Razbit/razpu/refs/bmow-arch.pdf

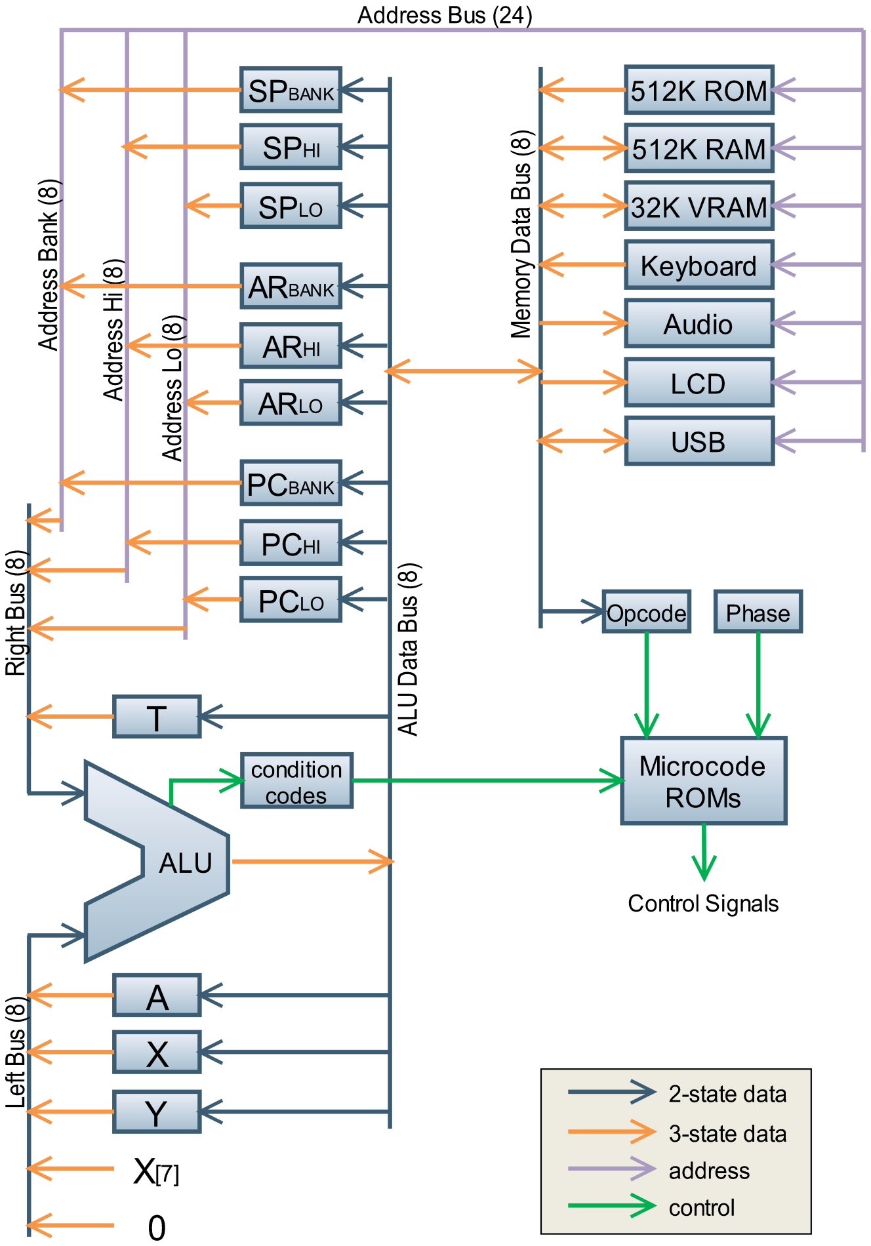
[picture p2: page 1]
