Razbit/razpu/refs/bmow-video.pdf

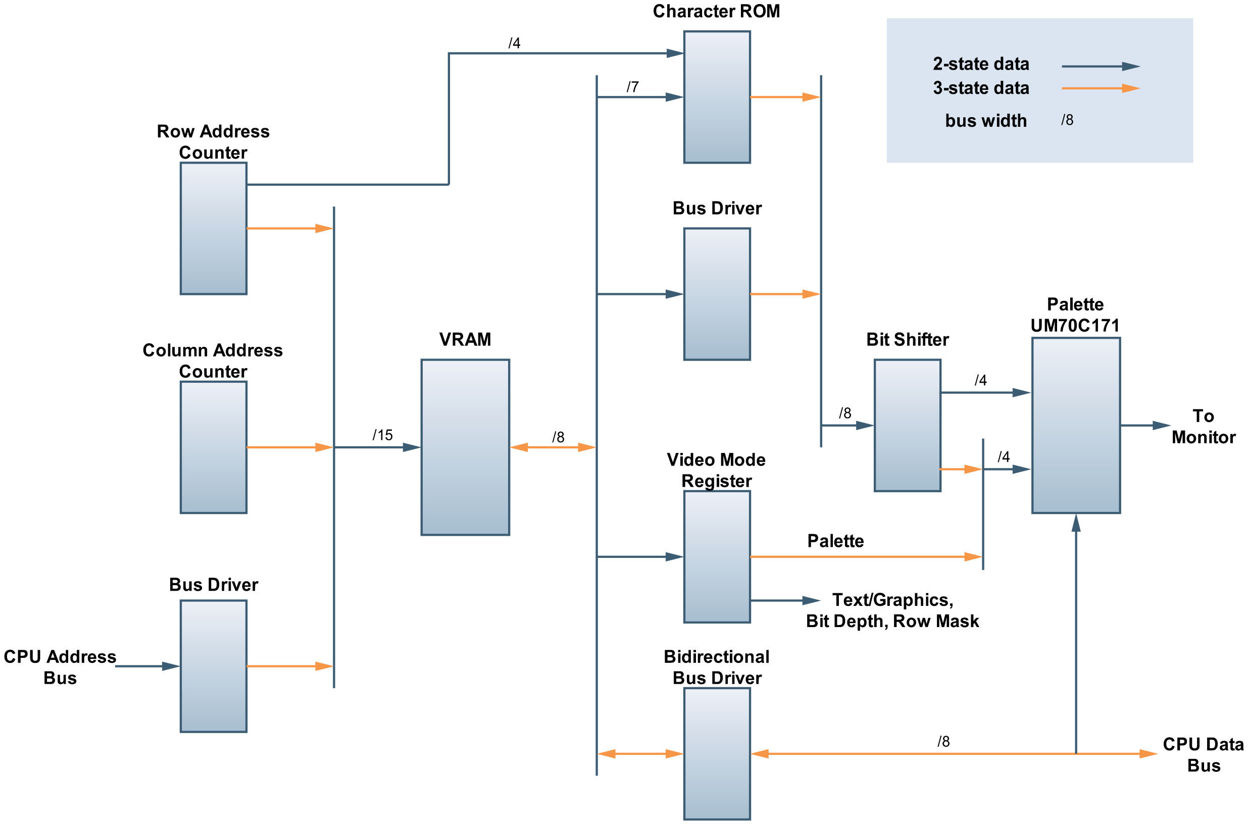
[picture p3: page 1]
