Razbit/razpu/rpu_mk1/schematic.pdf

U1

U2A

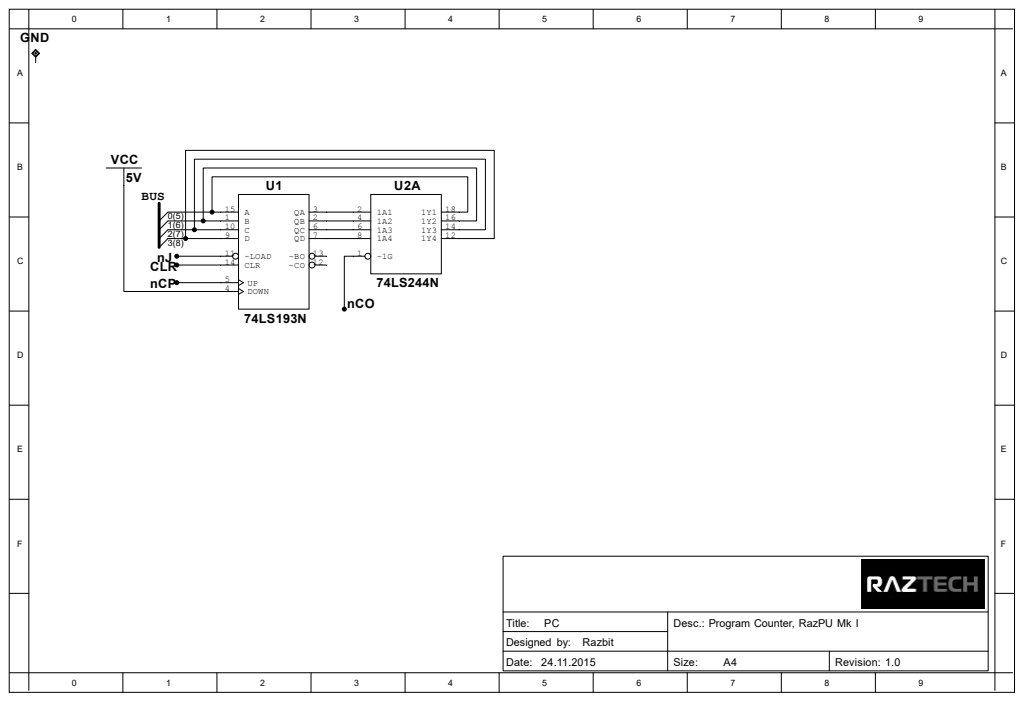
[picture p4: page 1]
DOWN 4; ~LOAD 11; ~CO 12 CLR 14; nCO; nCP; CLRnJ; VCC 5V BUS; Title: Designed by:; Date:; Revision: Size:; Program Counter, RazPU Mk I; Razbit 24.11.2015 1.0 A4; Desc.:; GND

U2

U1

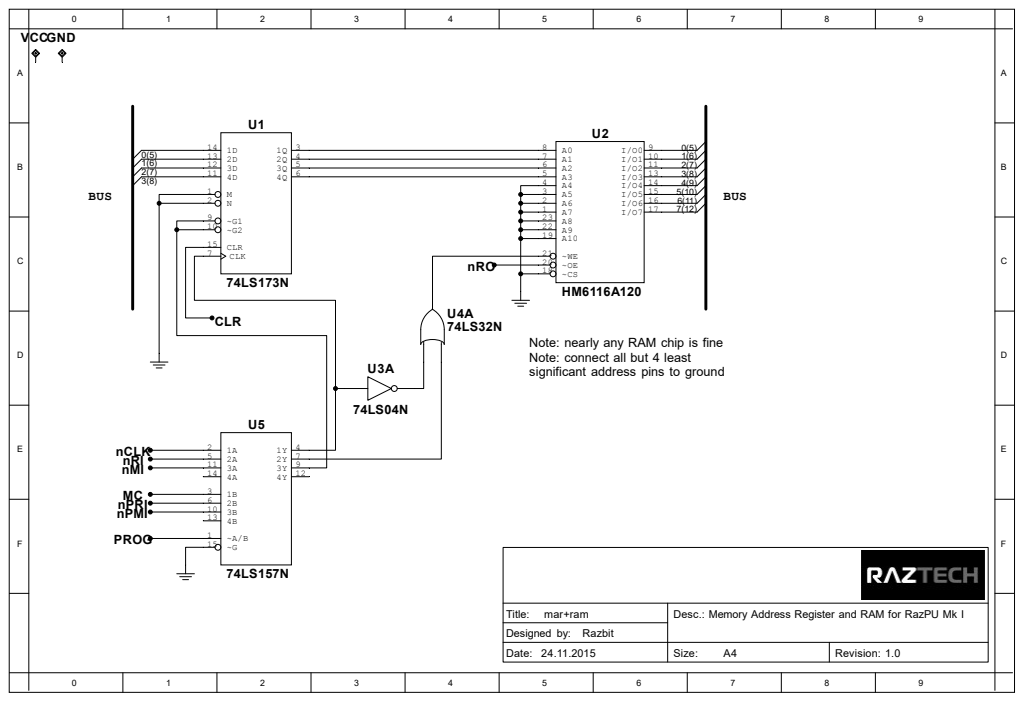
[picture p5: page 2]
nRO; Note: nearly any RAM chip is fine Note: connect all but 4 least significant address pins to ground; BUS; CLR; Title: Designed by:; Date:; Revision: Size:; mar+ram; Memory Address Register and RAM for RazPU Mk I; Razbit 24.11.2015 1.0 A4; Desc.:; ~G1 9 CLR 15; CLK 7; nCLK; PROG; nRI; nPRI; nMI; nPMI; VCCGND

U1

## nIO

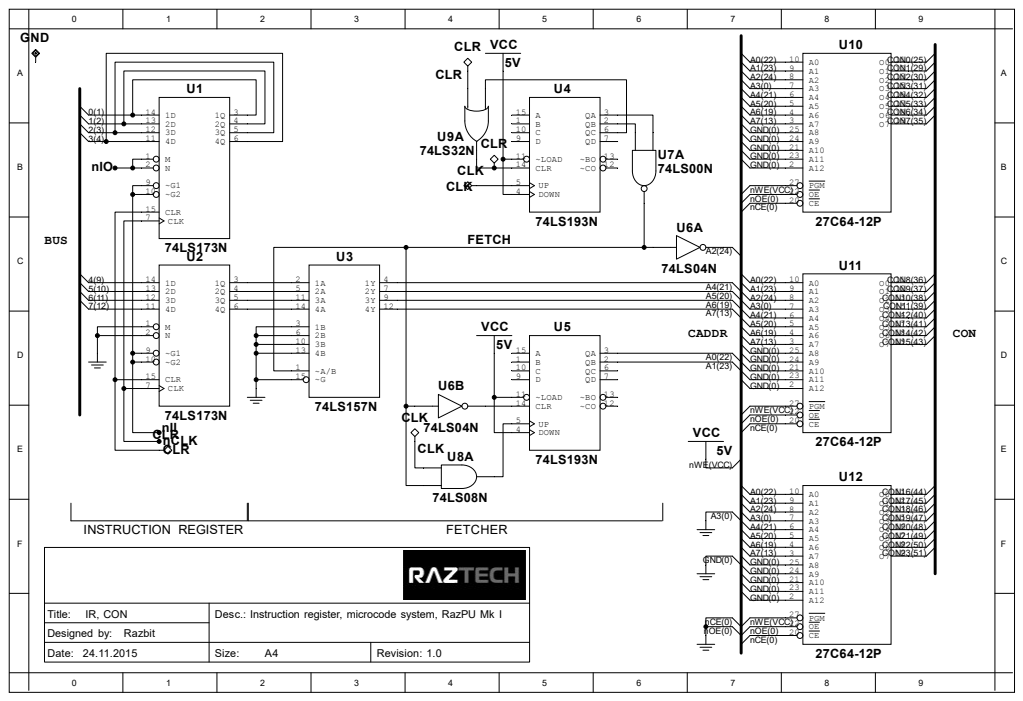
[picture p6: page 3]

GT

EQ

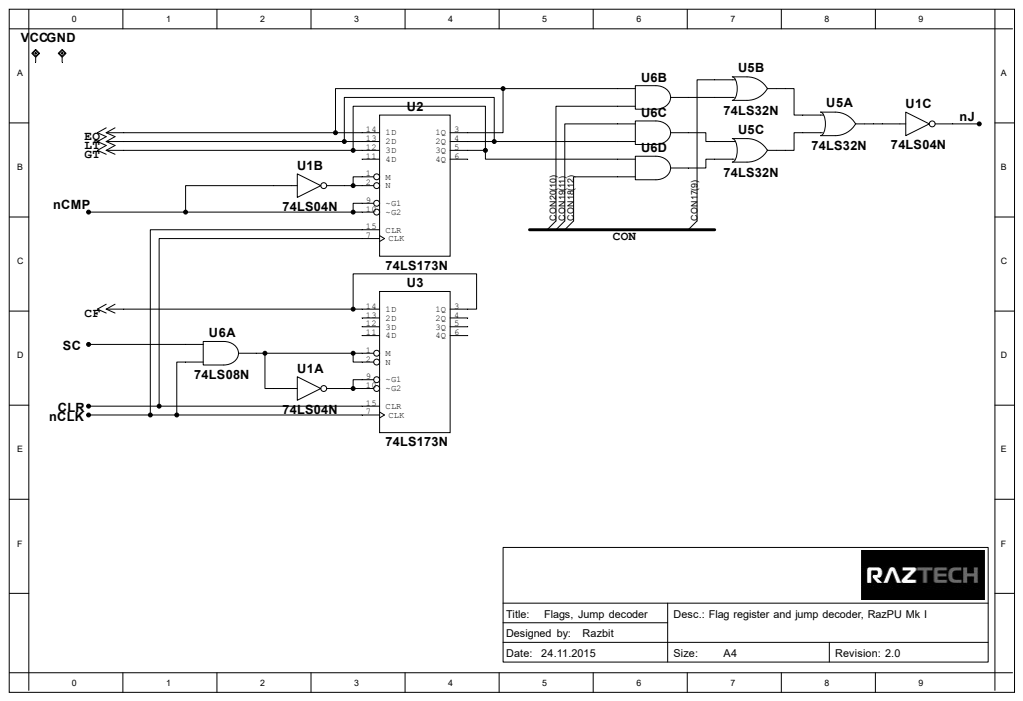
[picture p7: page 4]

U4A

U5

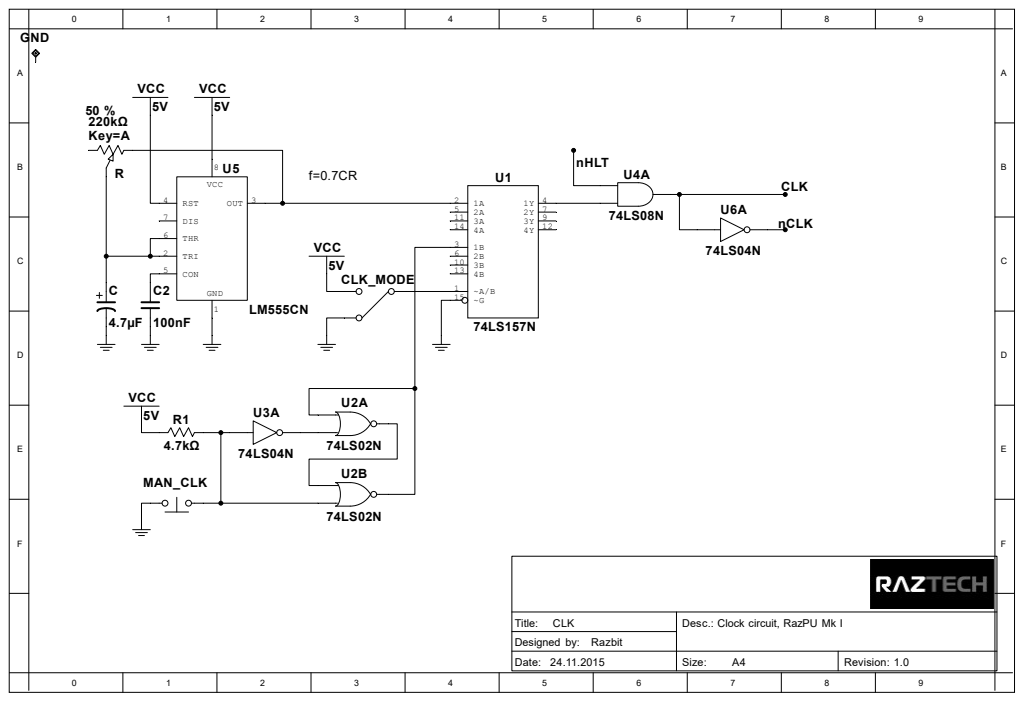
[picture p8: page 5]
GND 1; DIS 7; OUT 3 RST 4; VCC; THR 6; CON 5; TRI 2; MAN_CLK; VCC 5V; CLK_MODE; nHLT; Title: Designed by:; Date:; Revision: Size:; CLK; Clock circuit, RazPU Mk I; Razbit 24.11.2015 1.0 A4; Desc.:; 220kΩ Key=A; CLK nCLK

U1A

U2

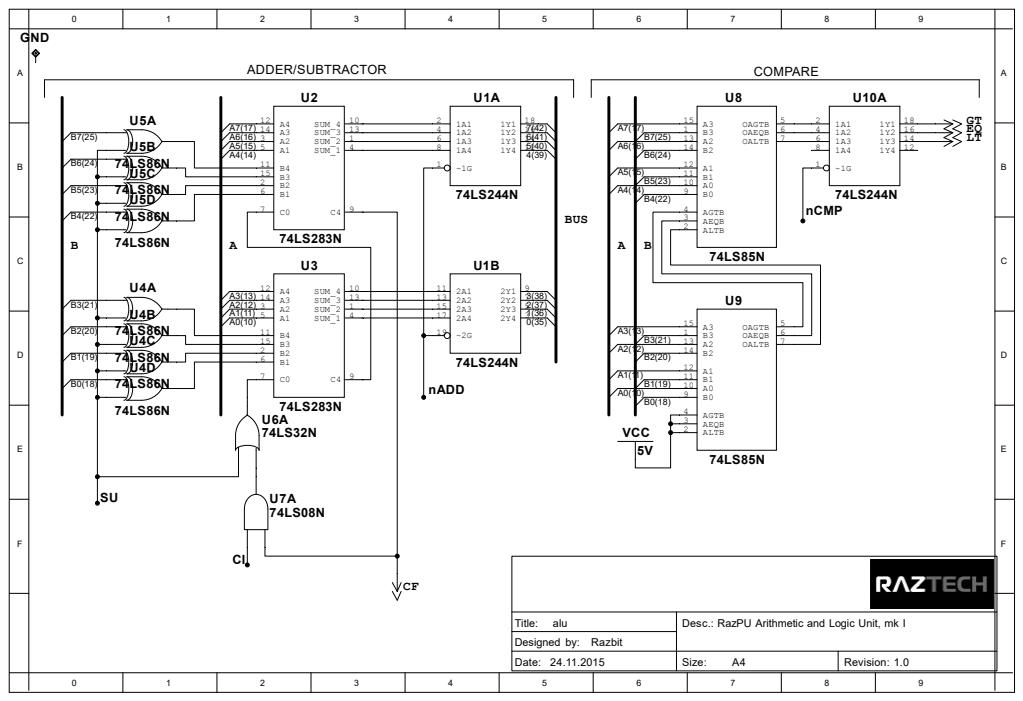
[picture p9: page 6]

U1B

## LPT

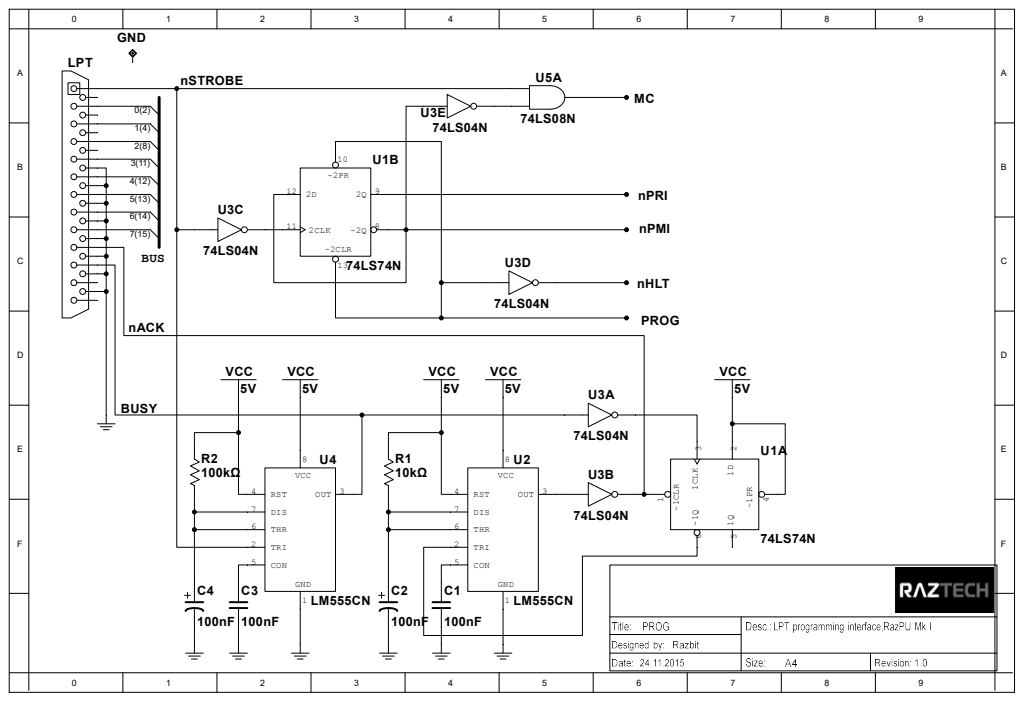
[picture p10: page 7]

U1A

U2

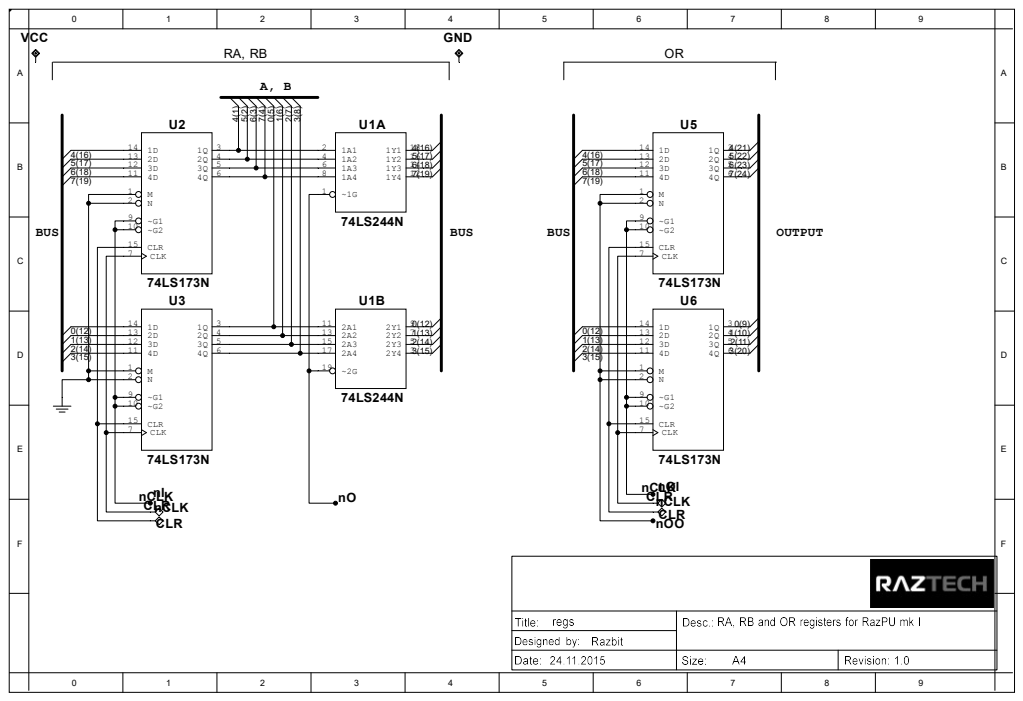
[picture p11: page 8]
~G1 9 CLR 15; CLK 7; BUS; nO nI nCLK; nOI; OUTPUT; nCLK; CLR CLR; nOO; CLR nCLK; VCC; GND
