Razbit/razpu/eeprom_prog.pdf

U4

U5A

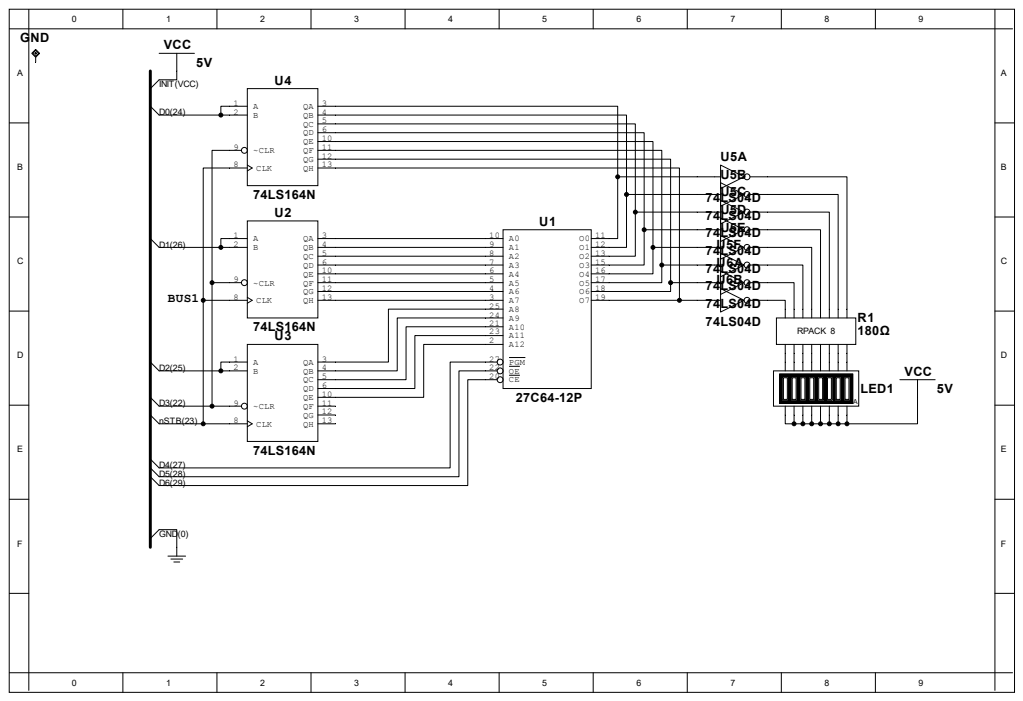
[picture p12: page 1]
