Razbit/razpu/razniffer/pcb_bottom.pdf

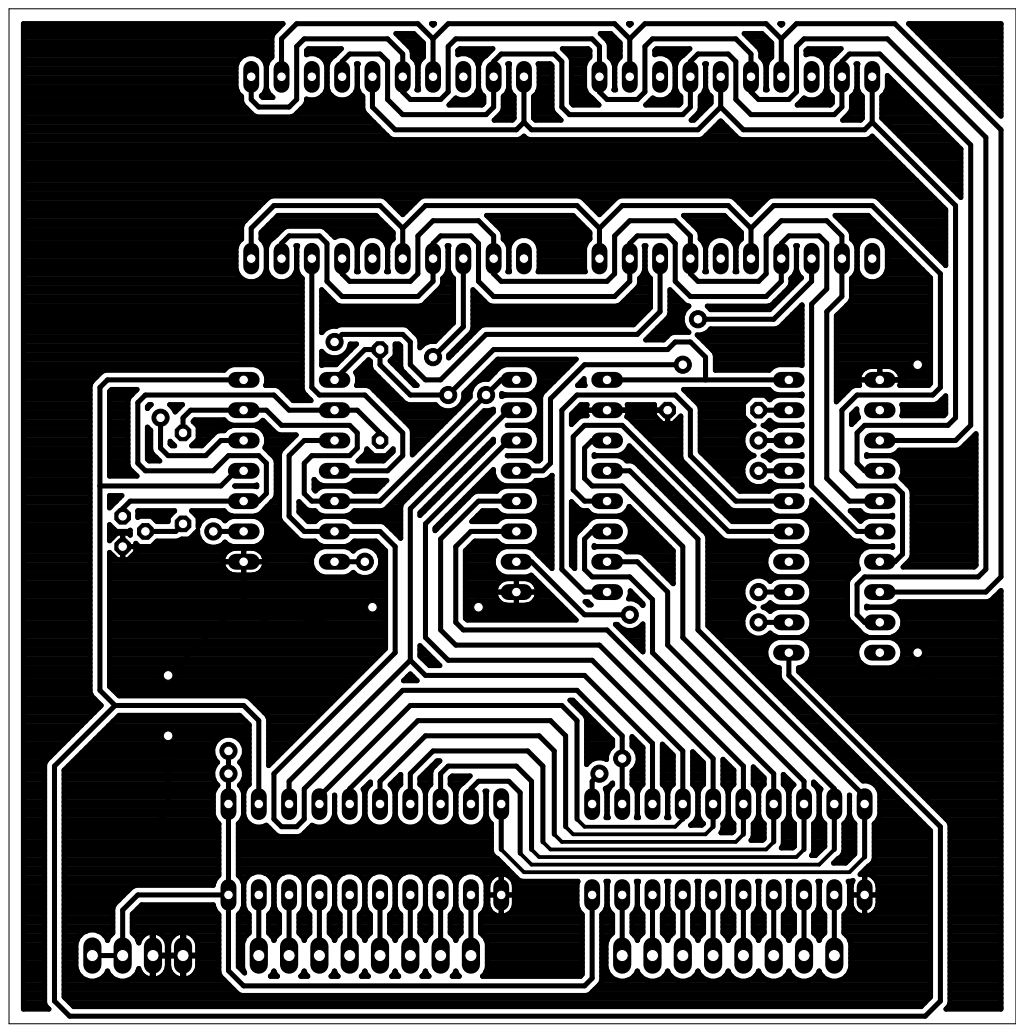
[picture p13: page 1]
