Razbit/razpu/razniffer/pcb_top.pdf

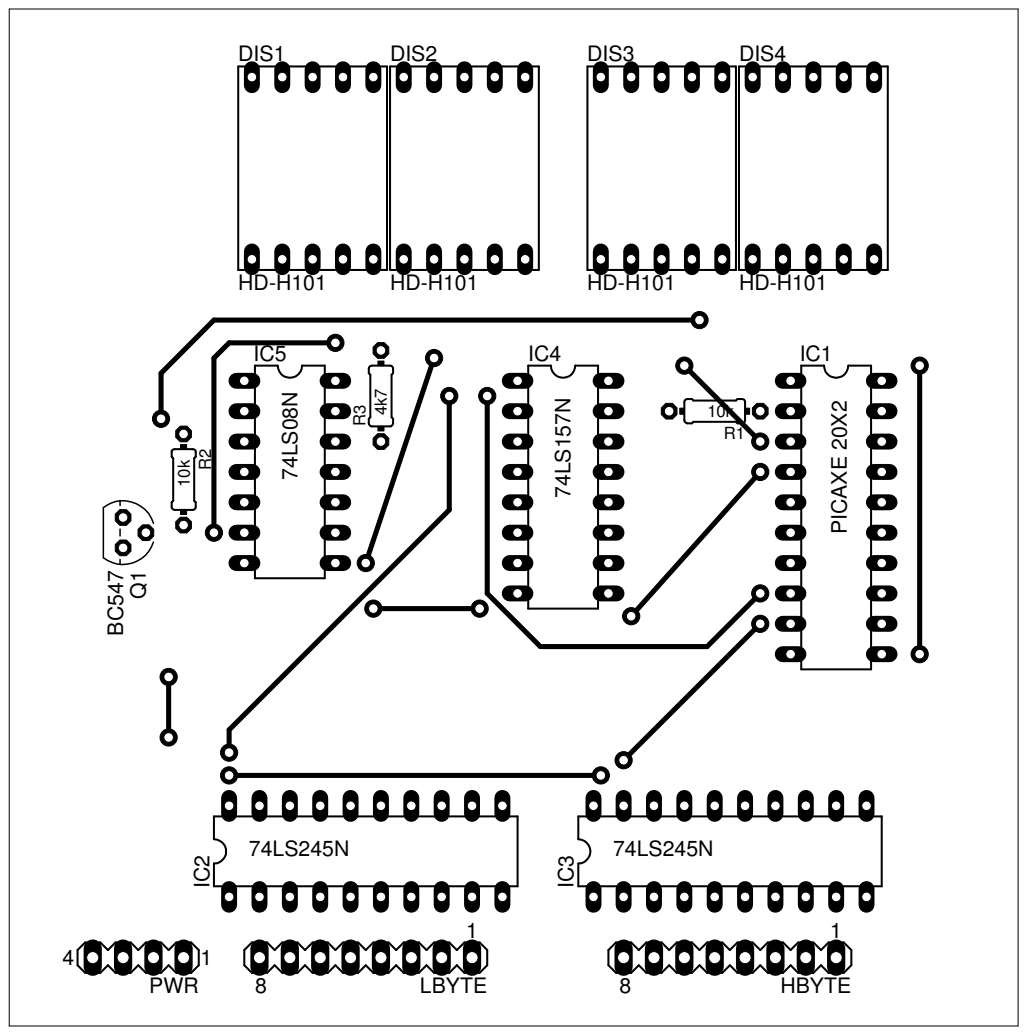
[picture p14: page 1]
