Razbit/razpu/refs/bmow-schema.pdf

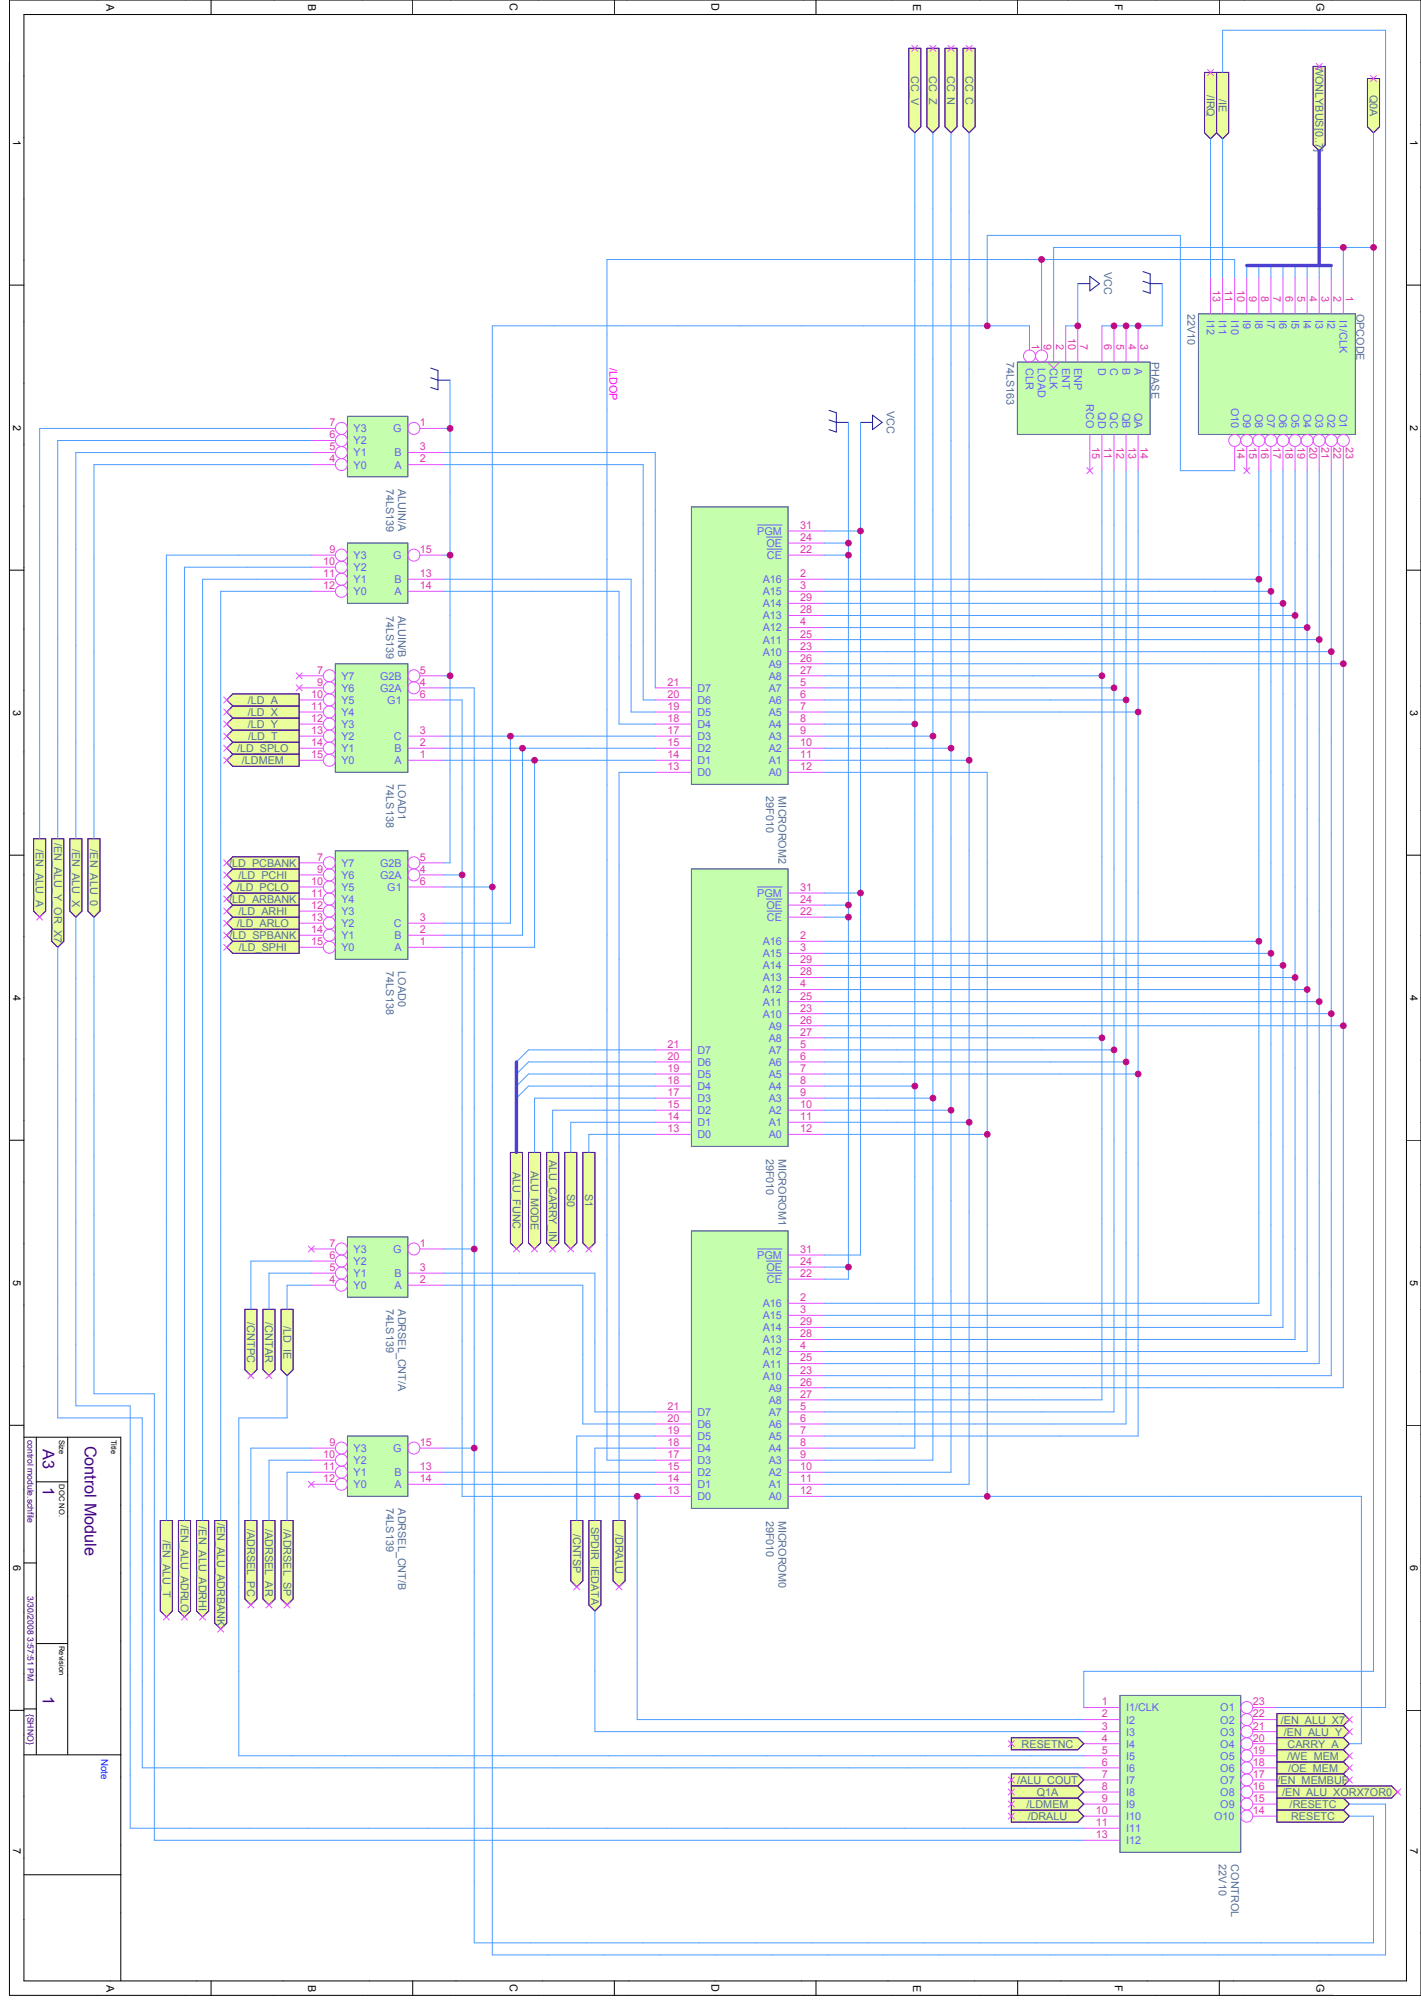
[picture p15: page 1]

3 A 14 QA 4 B 13 QB 5 C 12 QC 6 D 11 QD 15 RCO 7 ENP 10

23 A10
26 A9
27 A8

28 A13
25 A11 4

control module.schfile 3/30/2008 3:57:51 PM {SHNO}

Size DOC NO. Revision

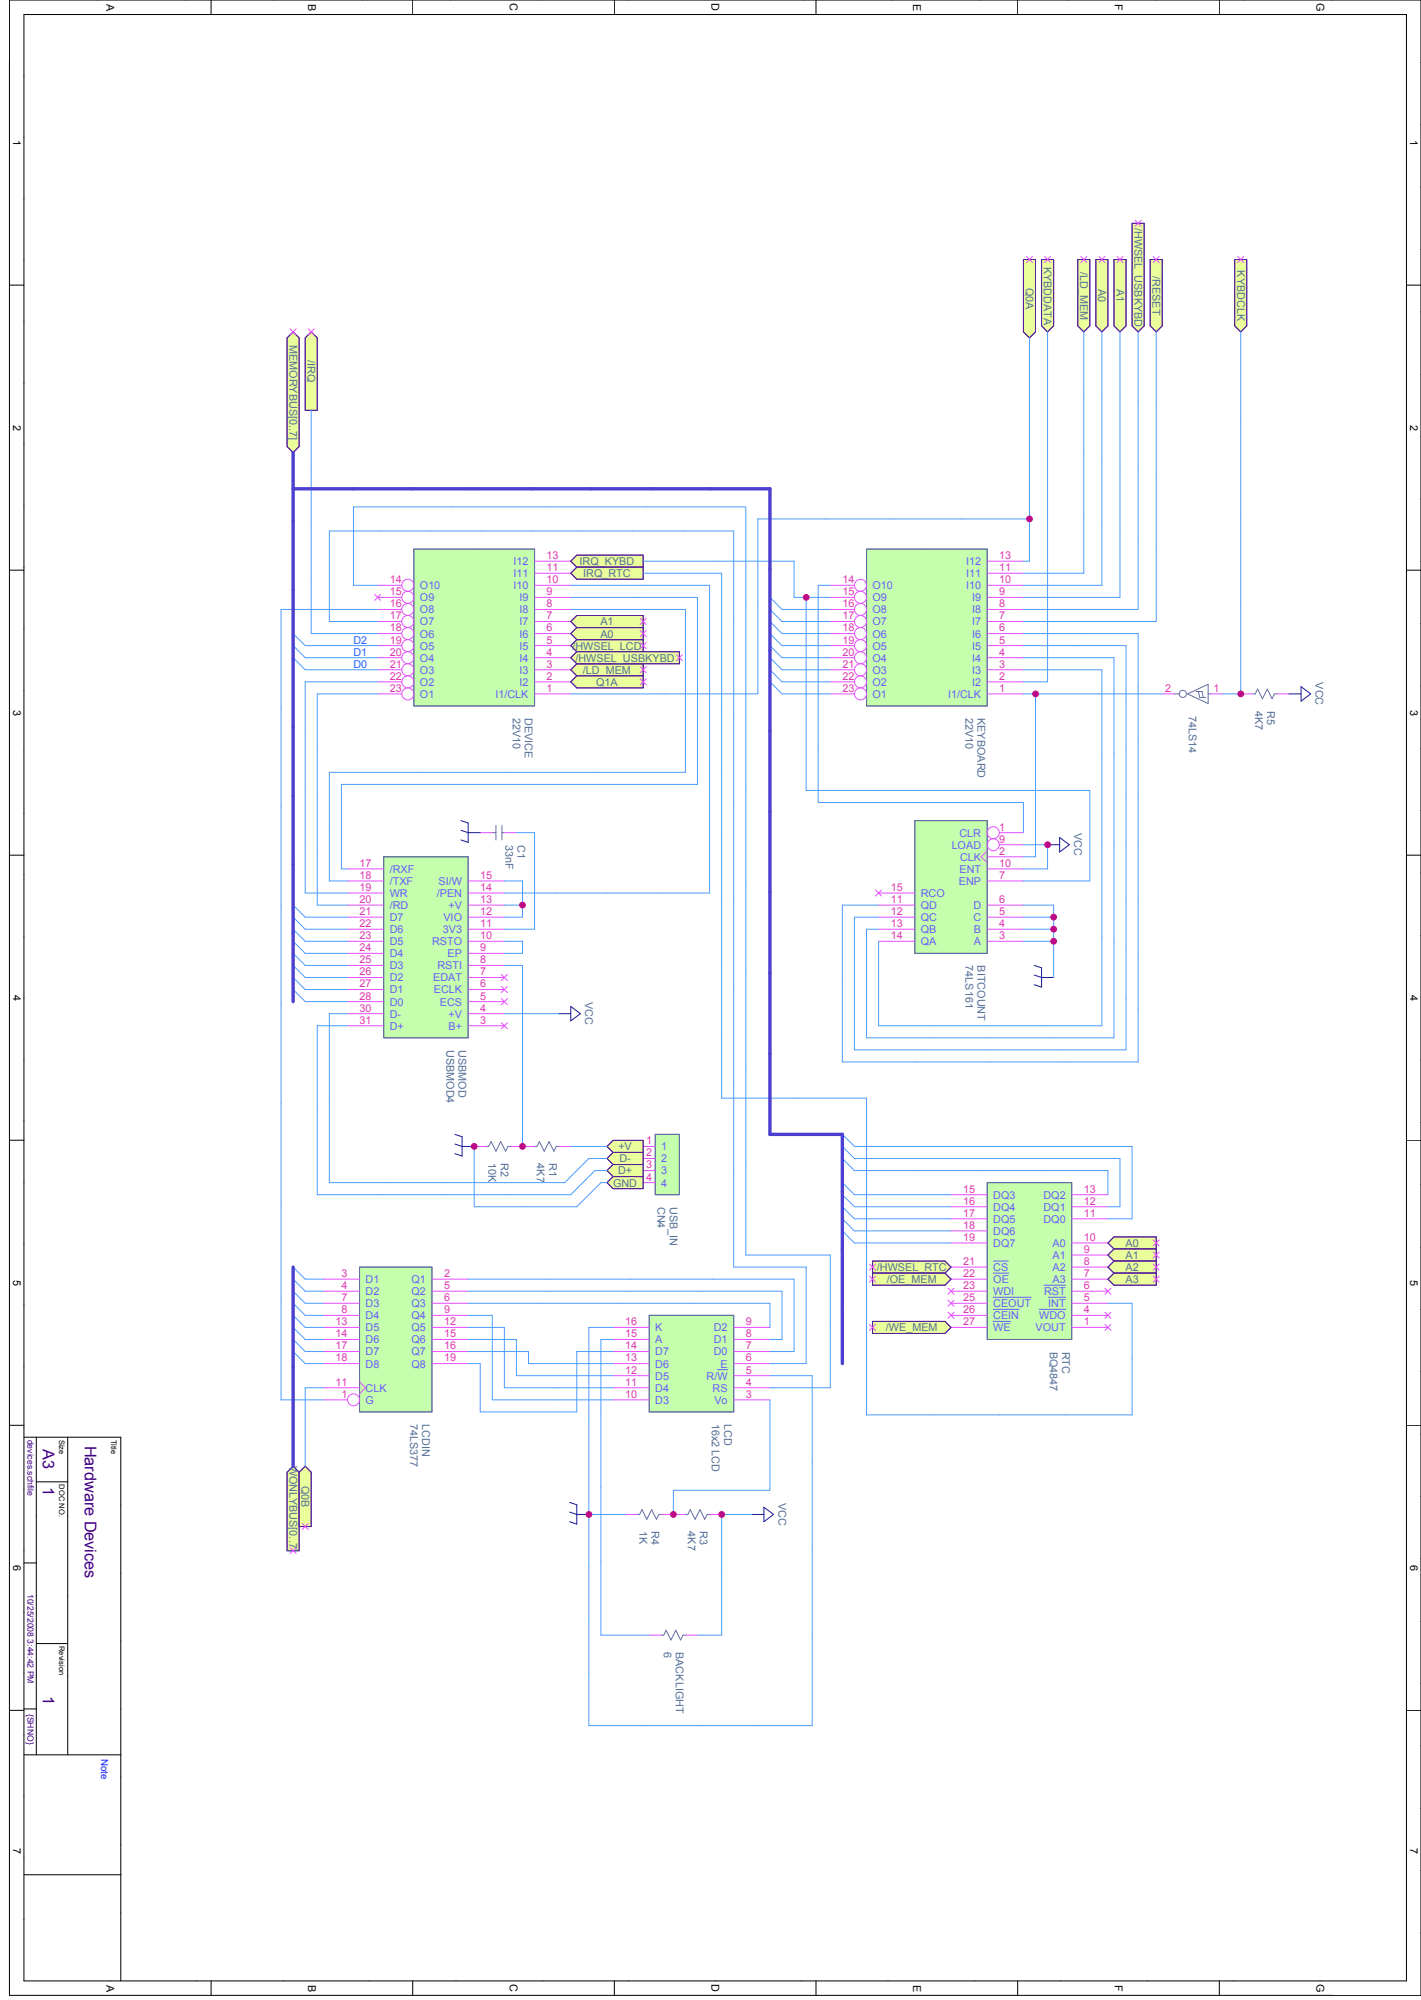
[picture p16: page 2]

devices.schfile 10/25/2008 3:44:42 PM {SHNO}

Size DOC NO. Revision

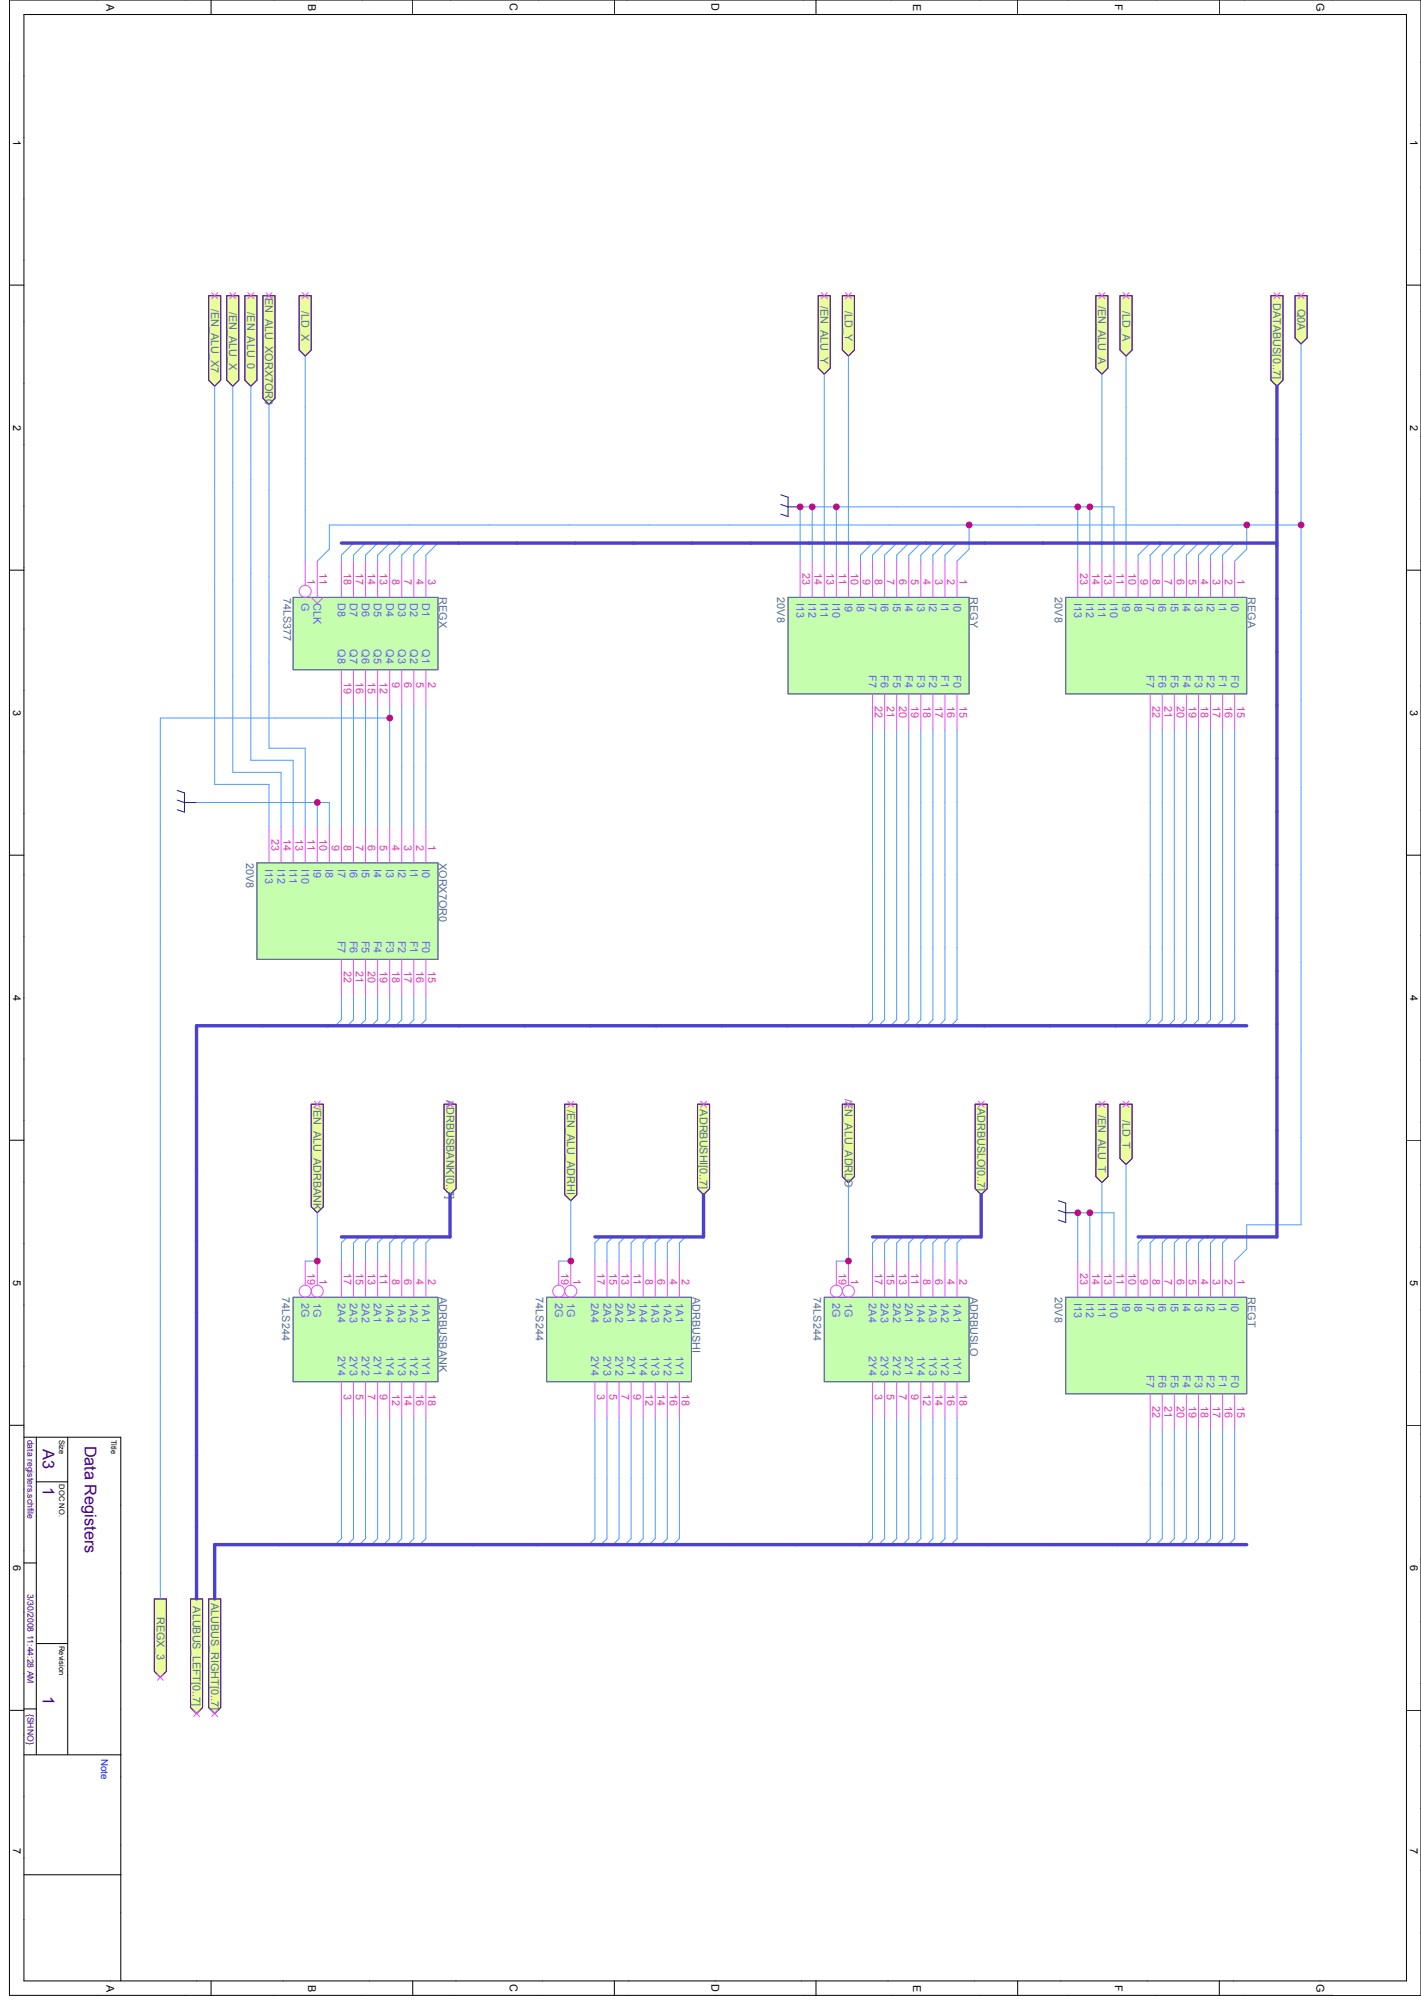
[picture p17: page 3]

data registers.schfile 3/30/2008 11:44:28 AM {SHNO}

Size DOC NO. Revision

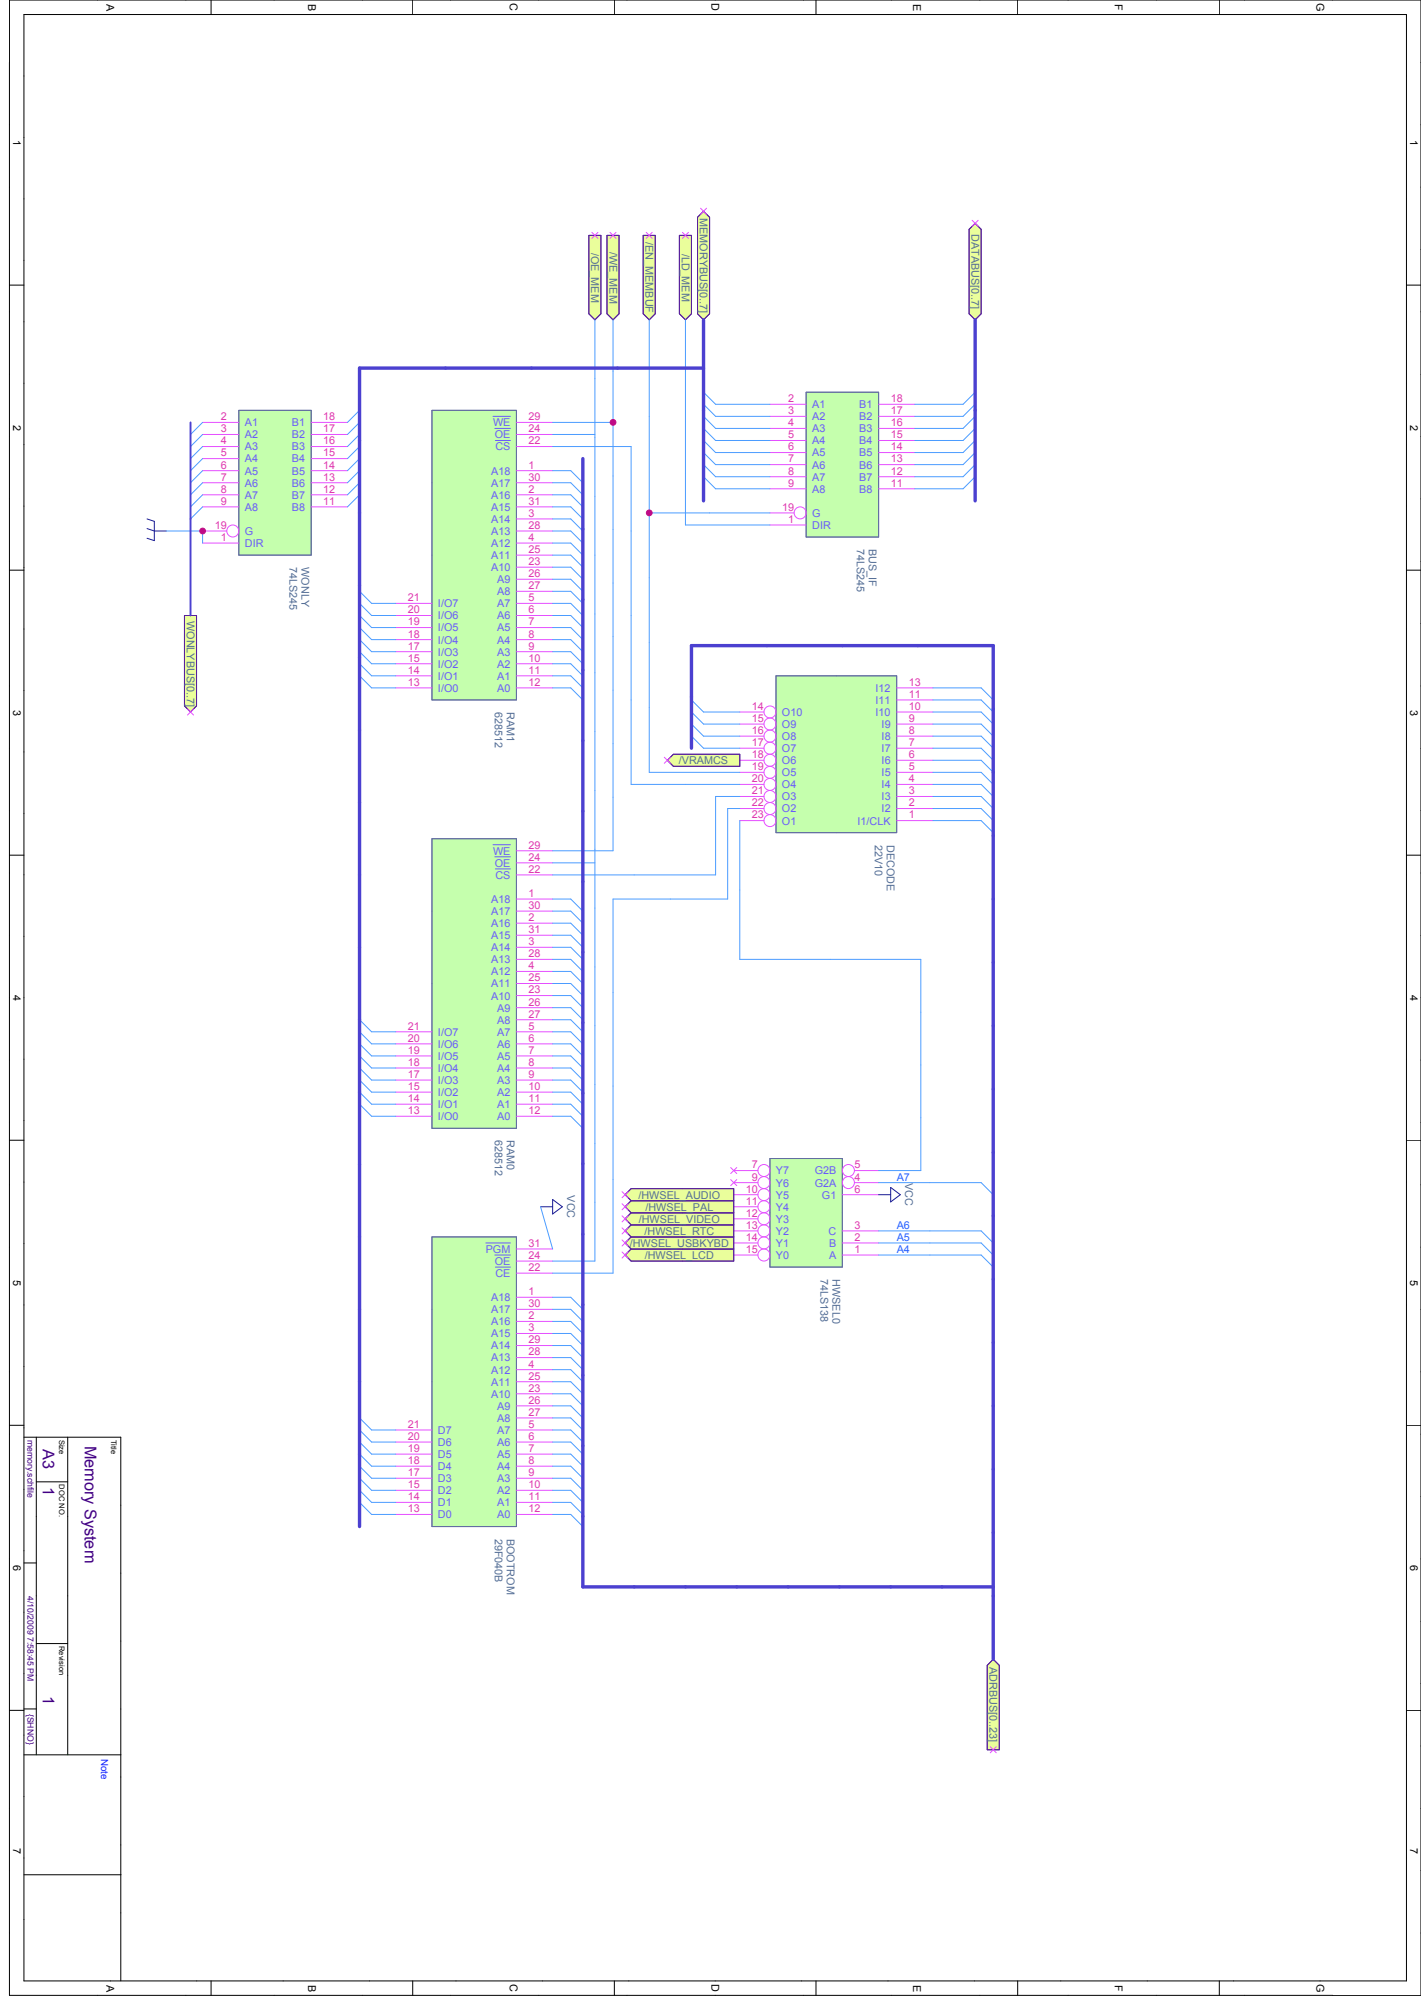
[picture p18: page 4]

memory.schfile 4/10/2009 7:58:45 PM {SHNO}

Size DOC NO. Revision

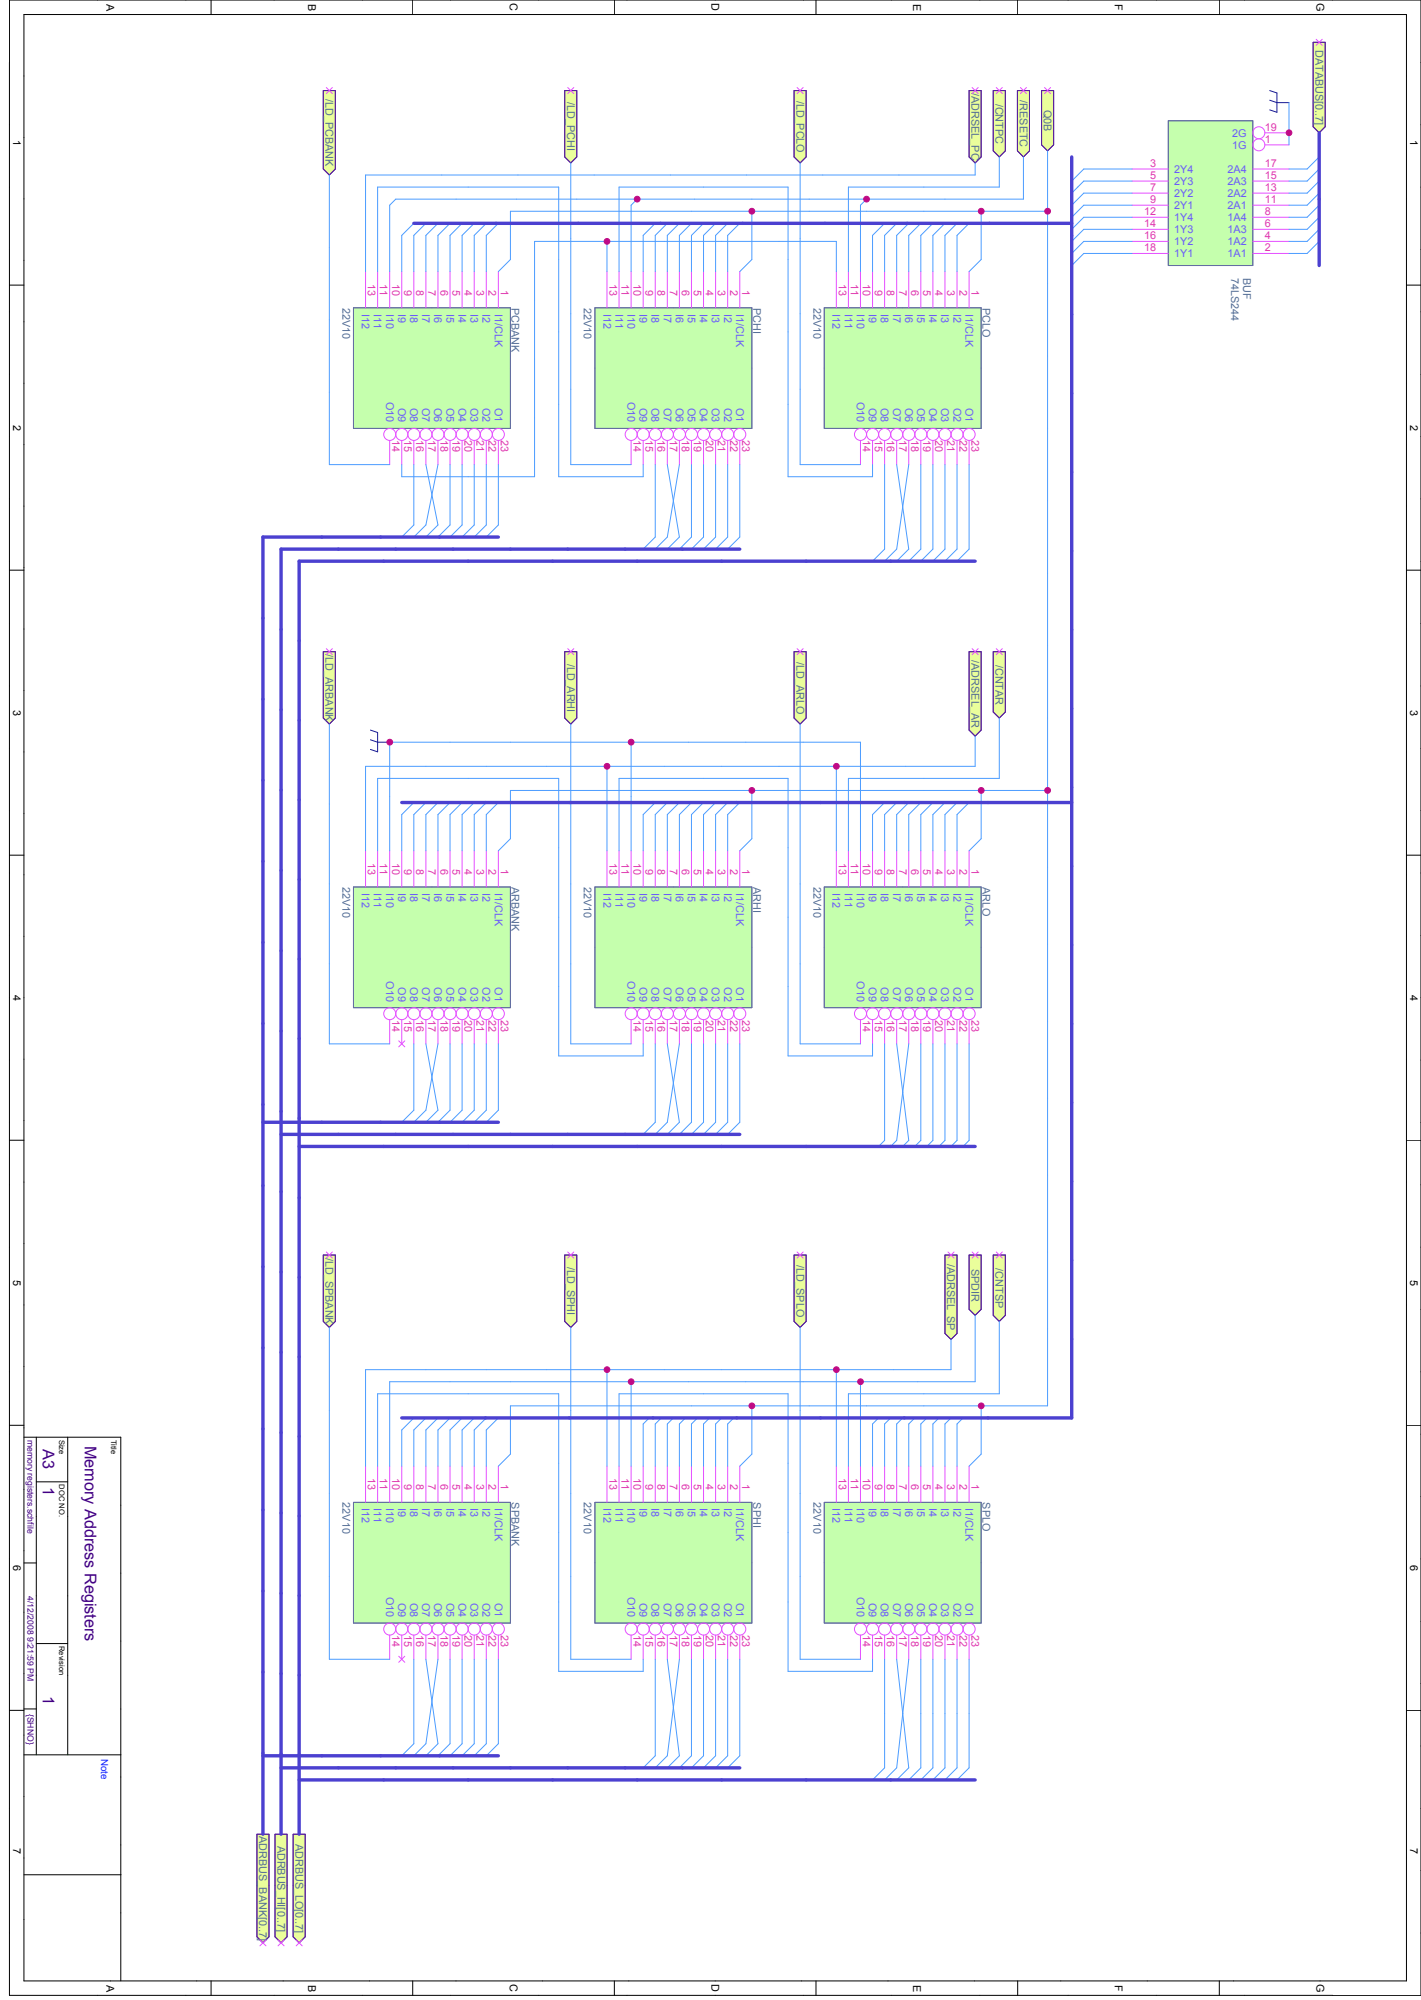
[picture p19: page 5]
Note; Title; PCLO; 1 I1/CLK; PCHI; PCBANK; ARLO; ARHI; ARBANK; SPLO; SPHI; SPBANK; BUF; /CNTPC; /ADRSEL_PC; /LD_PCBANK; /LD_PCHI; /LD_PCLO; /LD_ARHI; /LD_ARLO; /ADRSEL_AR; /LD_ARBANK; /LD_SPHI; /LD_SPLO; /LD_SPBANK; /CNTAR; SPDIR; /CNTSP; /ADRSEL_SP; DATABUS[0..7]; ADRBUS_BANK[0..7]; ADRBUS_HI[0..7]; ADRBUS_LO[0..7]; /RESETC

memory registers.schfile 4/12/2008 9:21:59 PM {SHNO}

Size DOC NO. Revision

Memory Address Registers

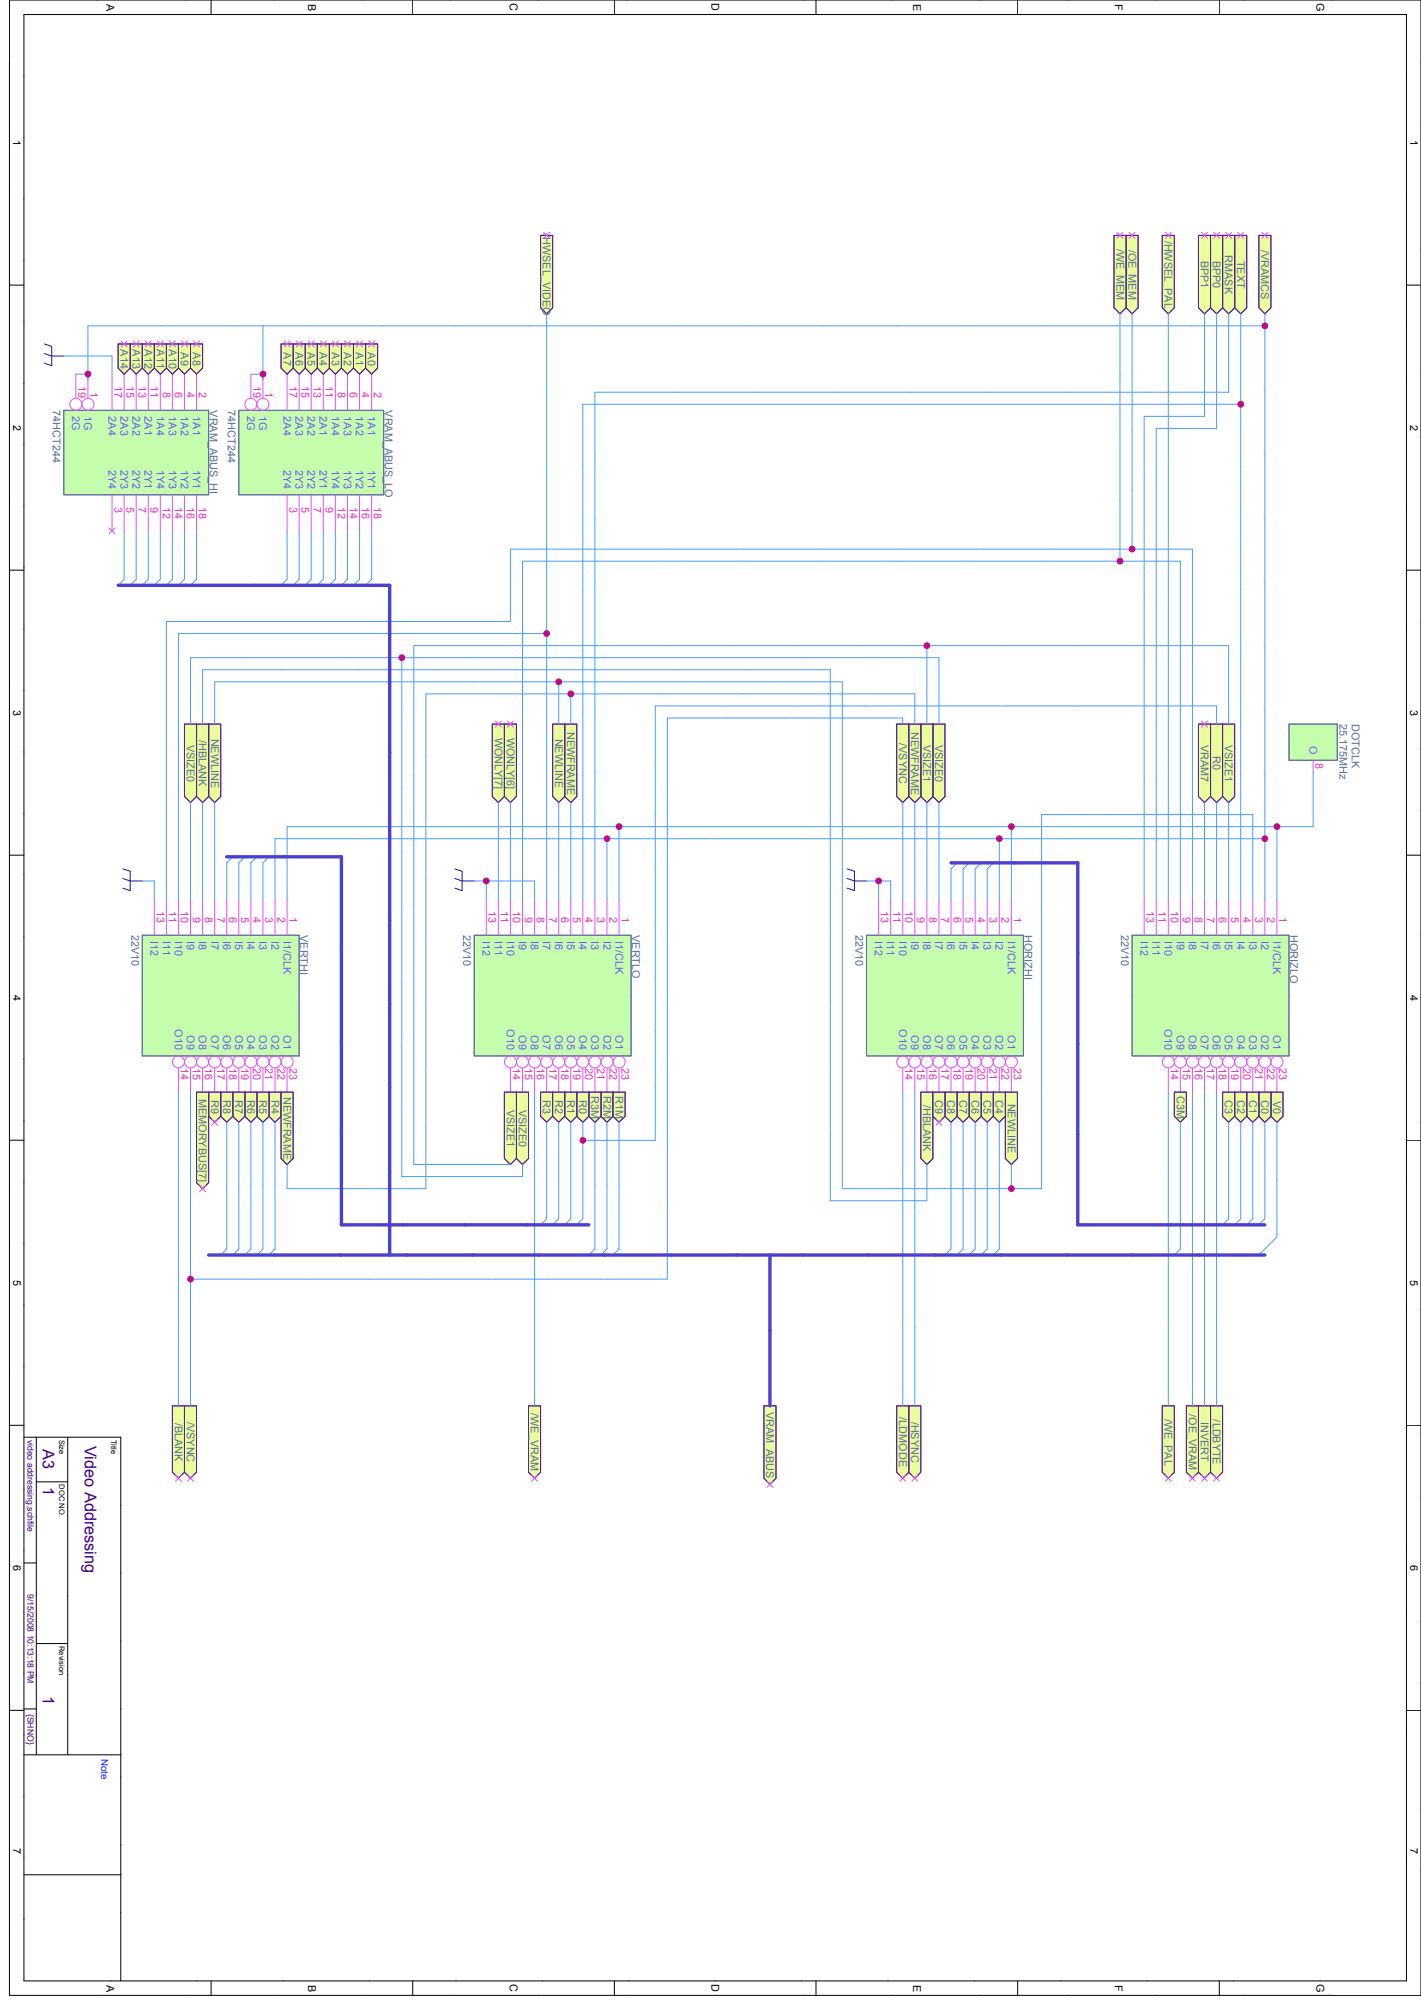
[picture p20: page 6]

video addressing.schfile 9/15/2008 10:13:18 PM {SHNO}

Size DOC NO. Revision

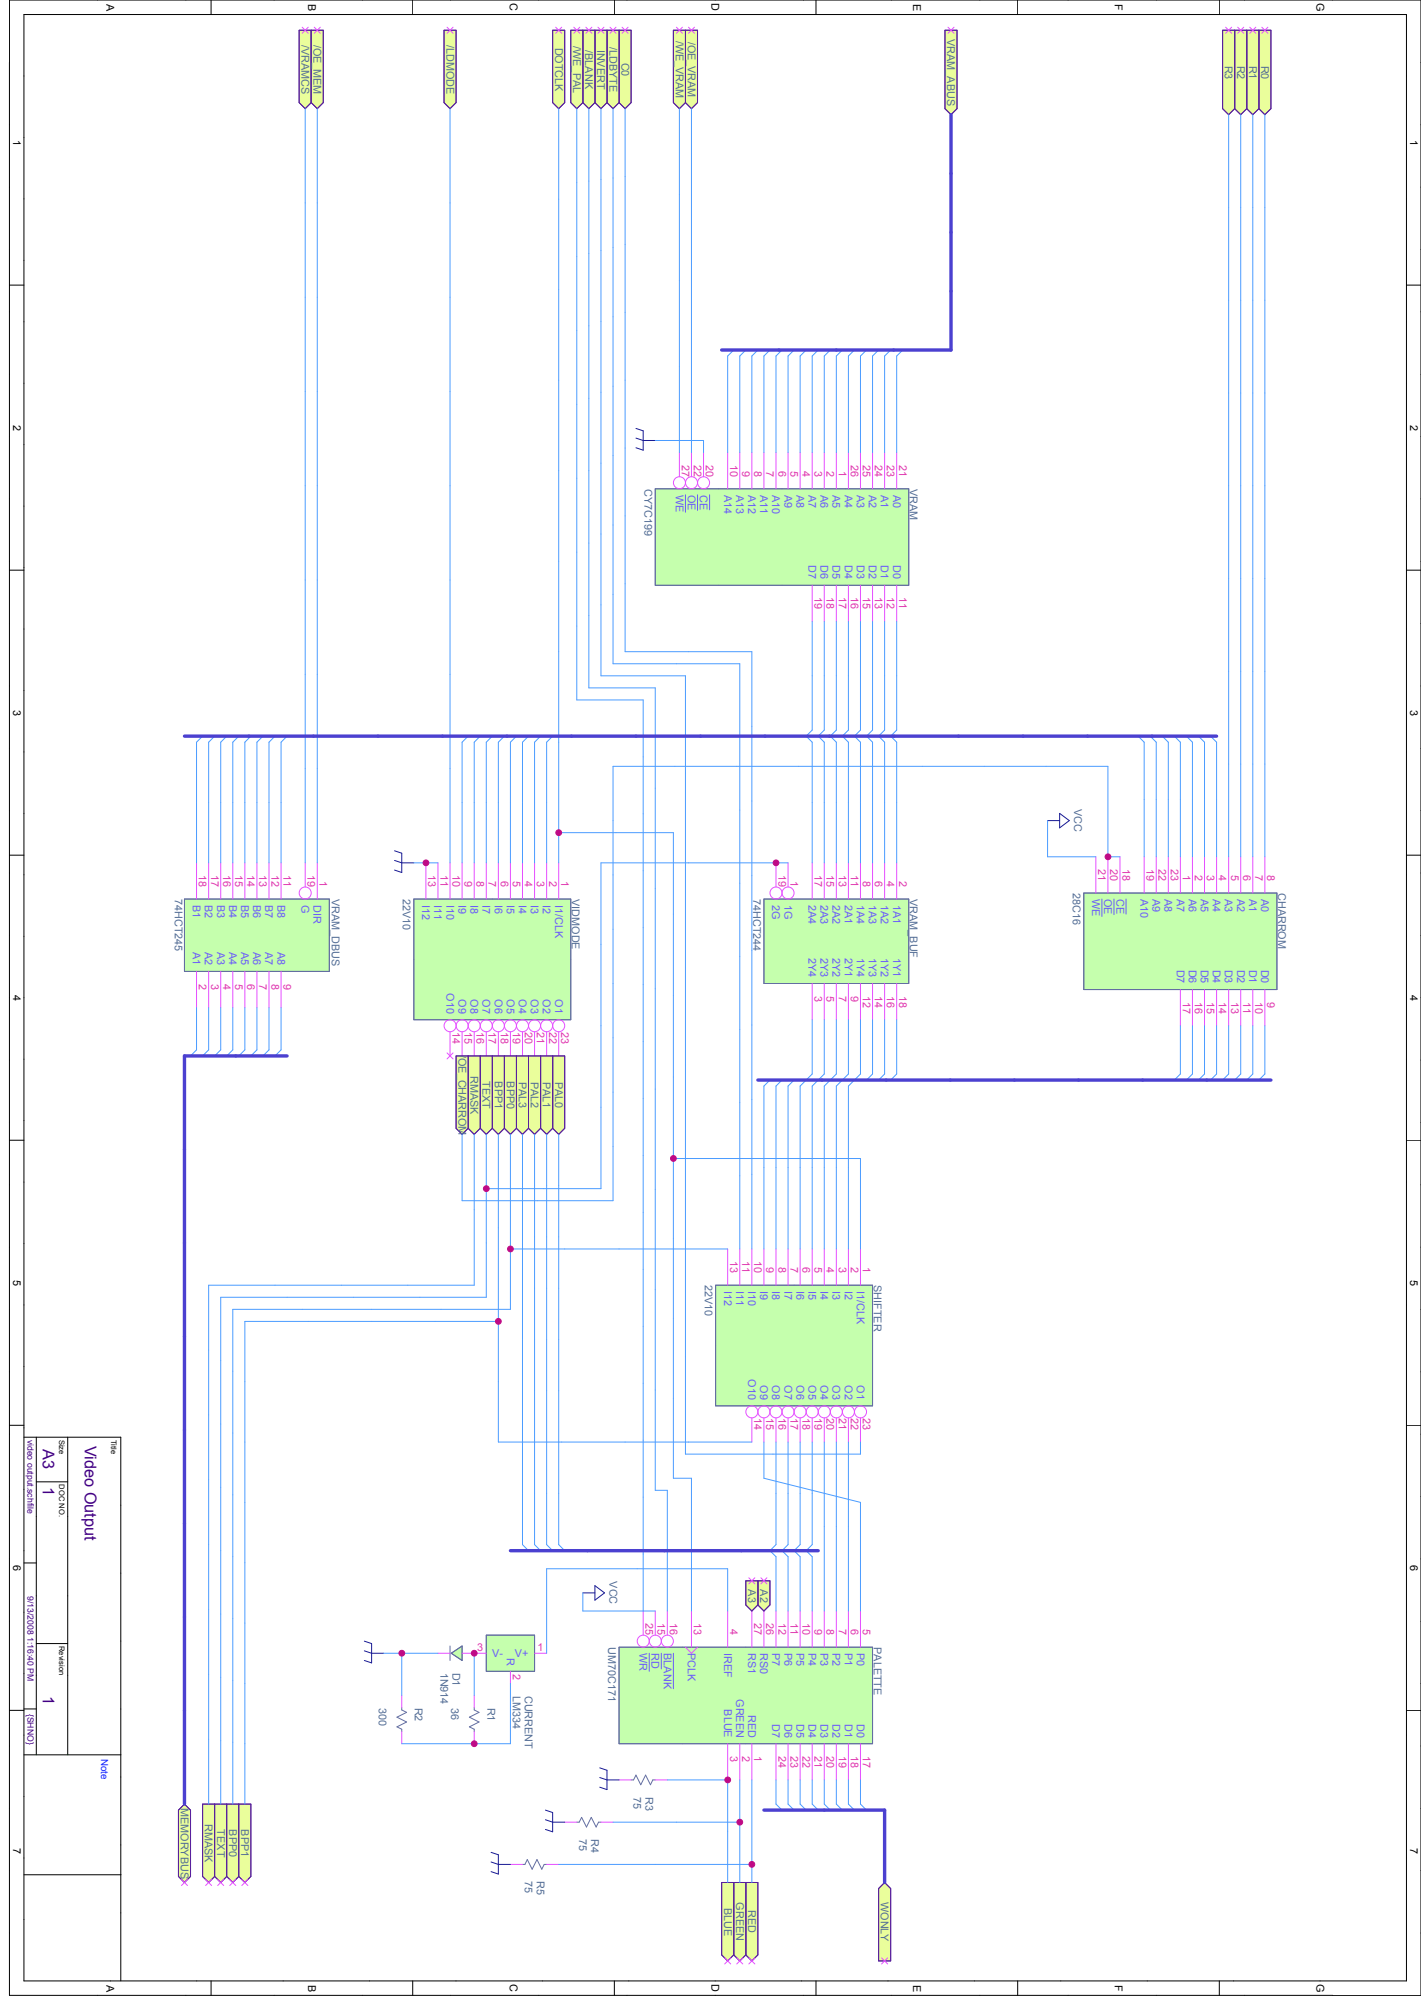
[picture p21: page 7]

video output.schfile 9/13/2008 1:16:40 PM {SHNO}

Size DOC NO. Revision

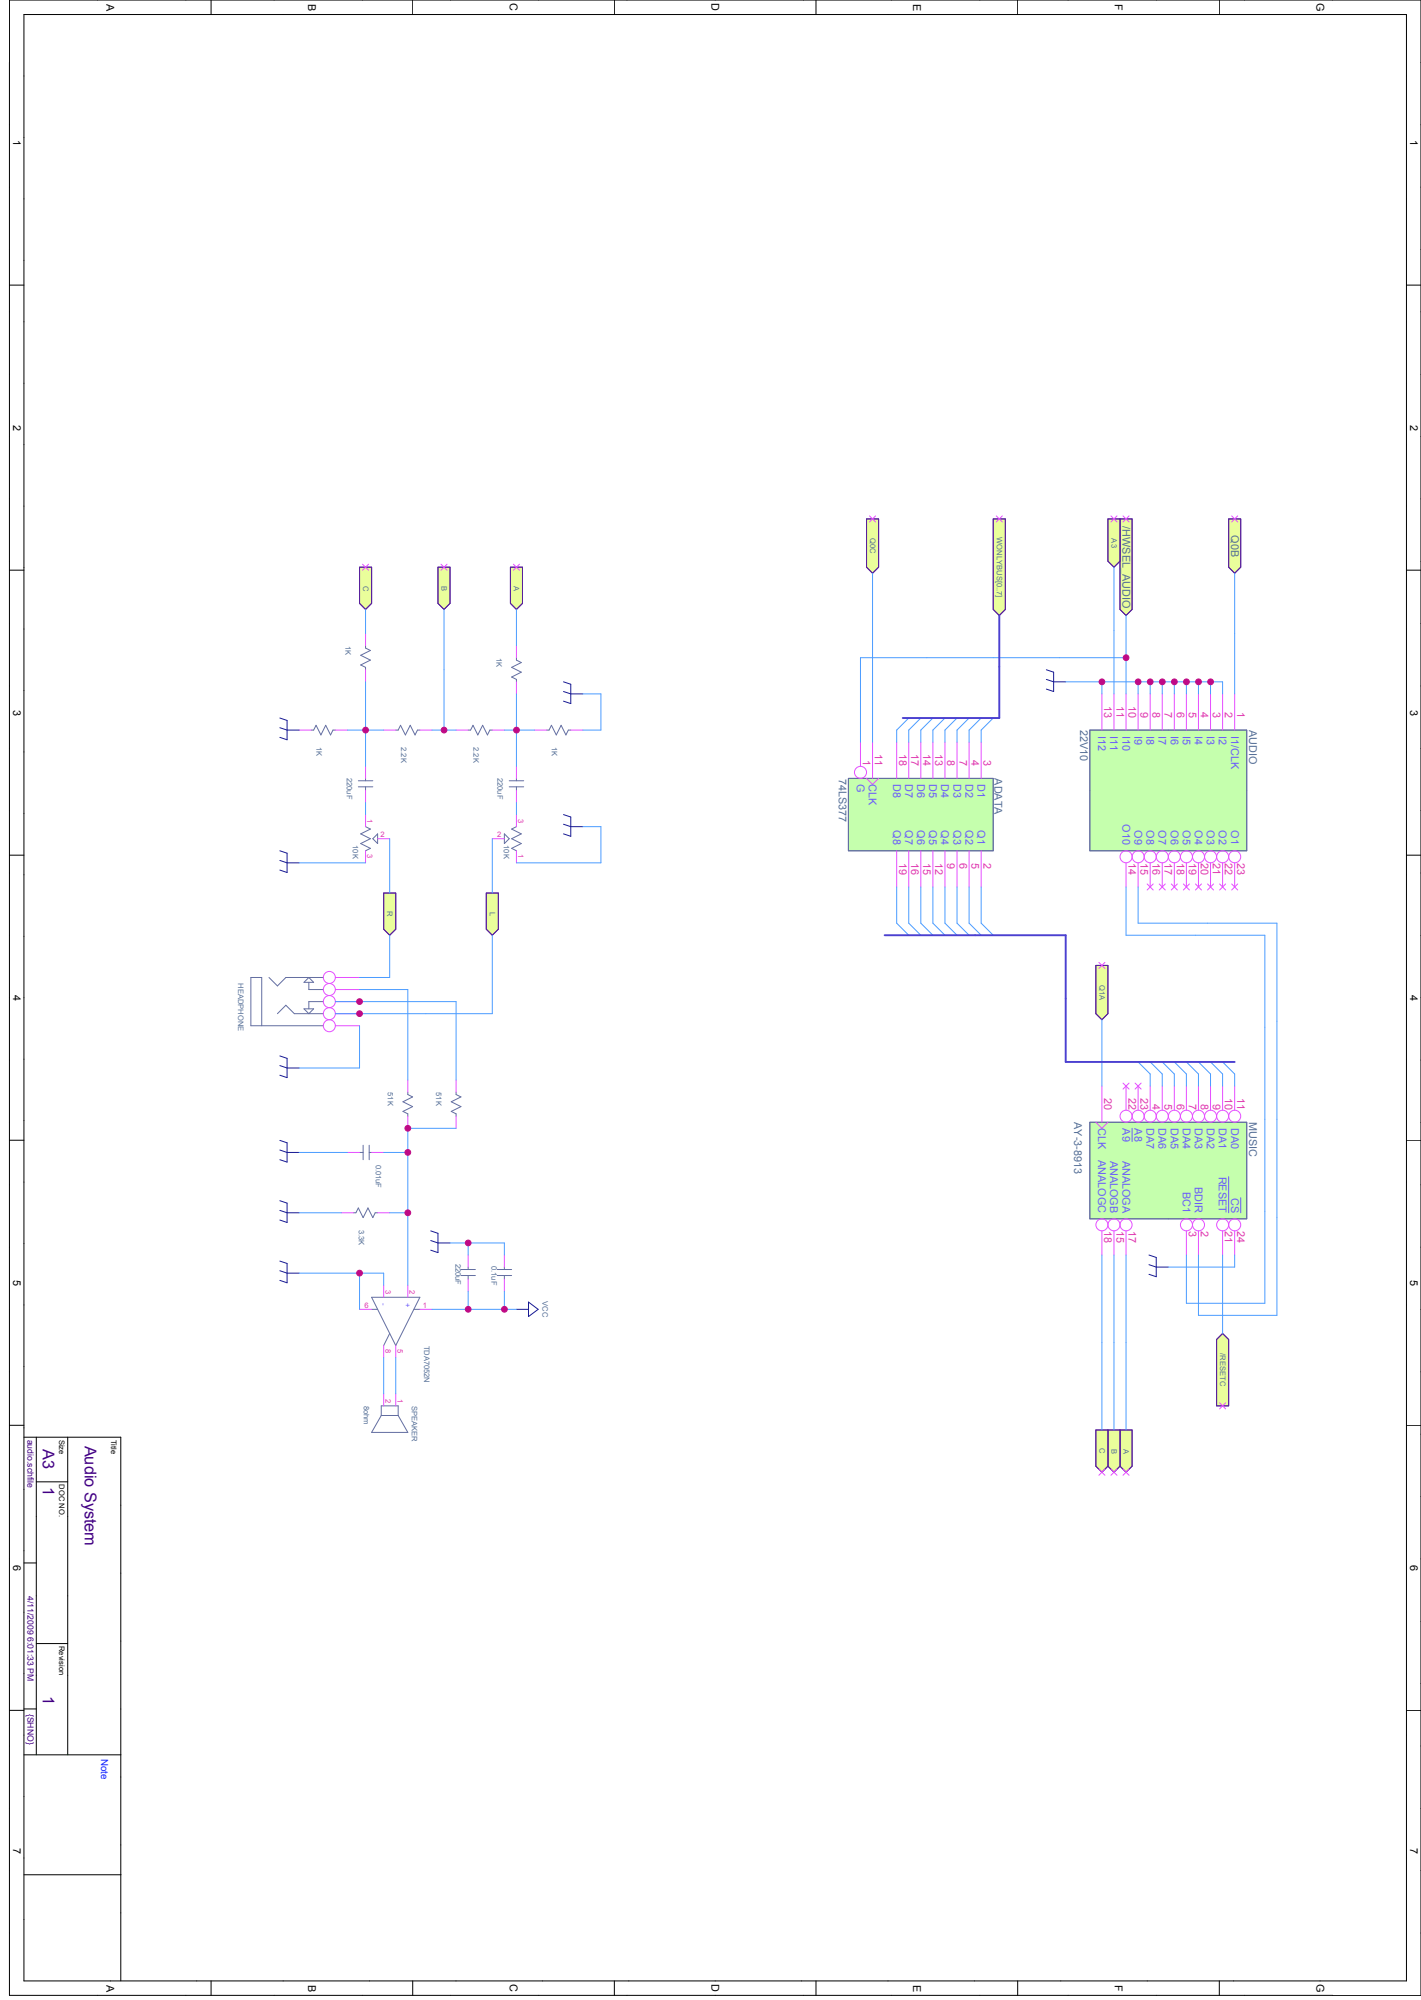
[picture p22: page 8]

audio.schfile 4/11/2009 6:01:33 PM {SHNO}

Size DOC NO. Revision

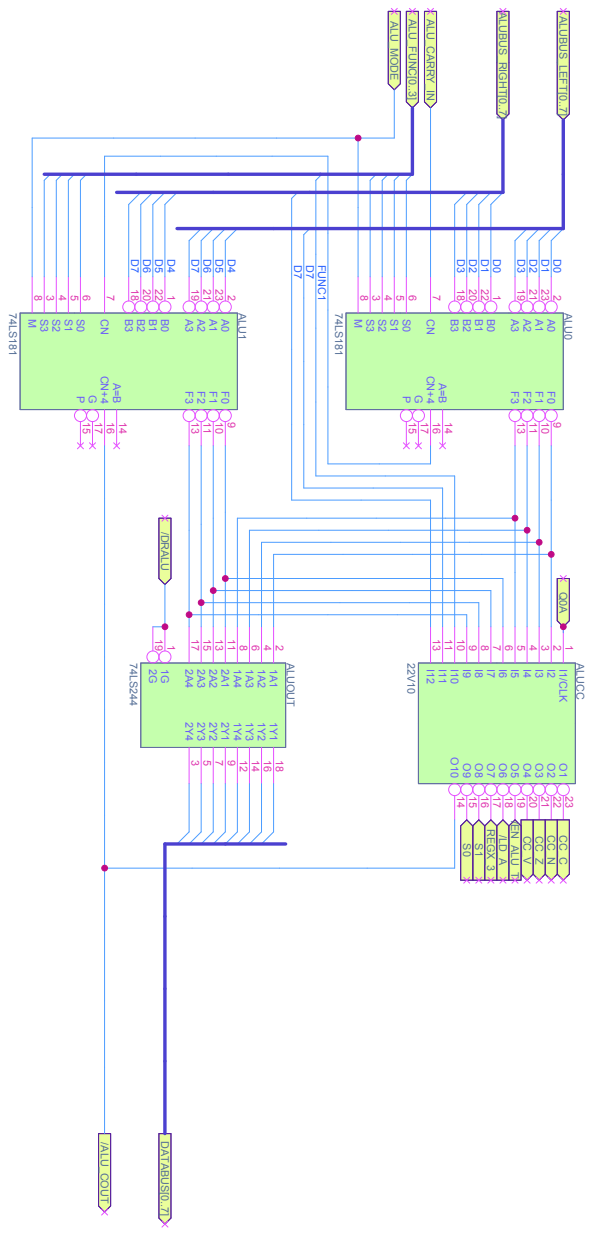
[picture p23: page 9]

ALU.schfile 11/10/2008 10:14:26 PM {SHNO}

Size DOC NO. Revision

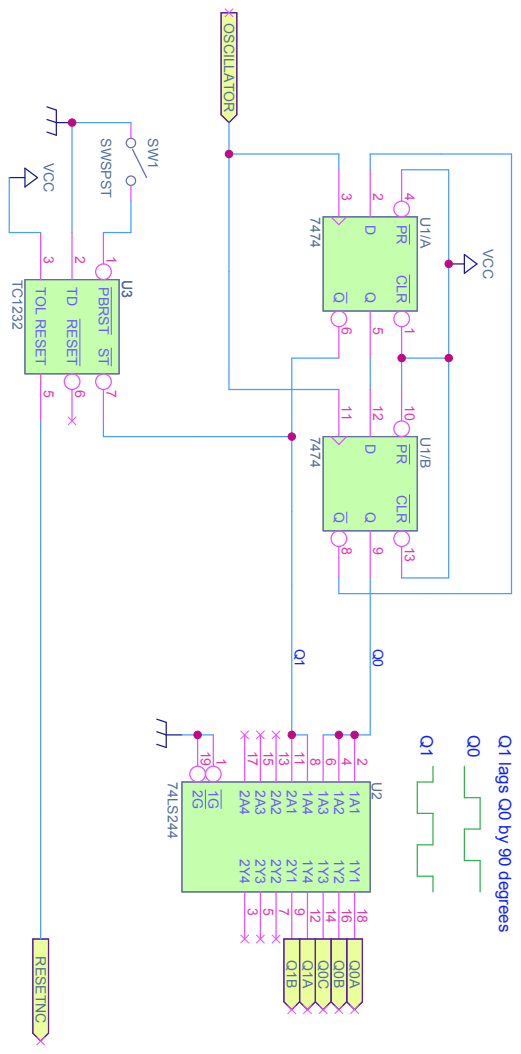
[picture p24: page 10]

clock generator.schfile 3/8/2008 4:05:28 PM {SHNO}

Size DOC NO. Revision
