Razbit/razpu/rpu_mk1/alu.pdf

U1A

U2
