Razbit/razpu/rpu_mk1/flags.pdf

GT

EQ
