Razbit/razpu/rpu_mk1/instr_reg+ctrl.pdf

U1

## nIO
