Razbit/razpu/(list of files, drawings)

Other design files:
eeprom_prog.ms10
rpu_mk1/alu.ms10
rpu_mk1/clk.ms10
rpu_mk1/flags.ms10
rpu_mk1/instr_reg+ctrl.ms10
rpu_mk1/mar_ram.ms10
rpu_mk1/pc.ms10
rpu_mk1/prog.ms10
rpu_mk1/regs.ms10
