Razbit/razpu/razniffer/razniffer.brd

## EAGLE design razniffer/razniffer.brd (2015-11-24)

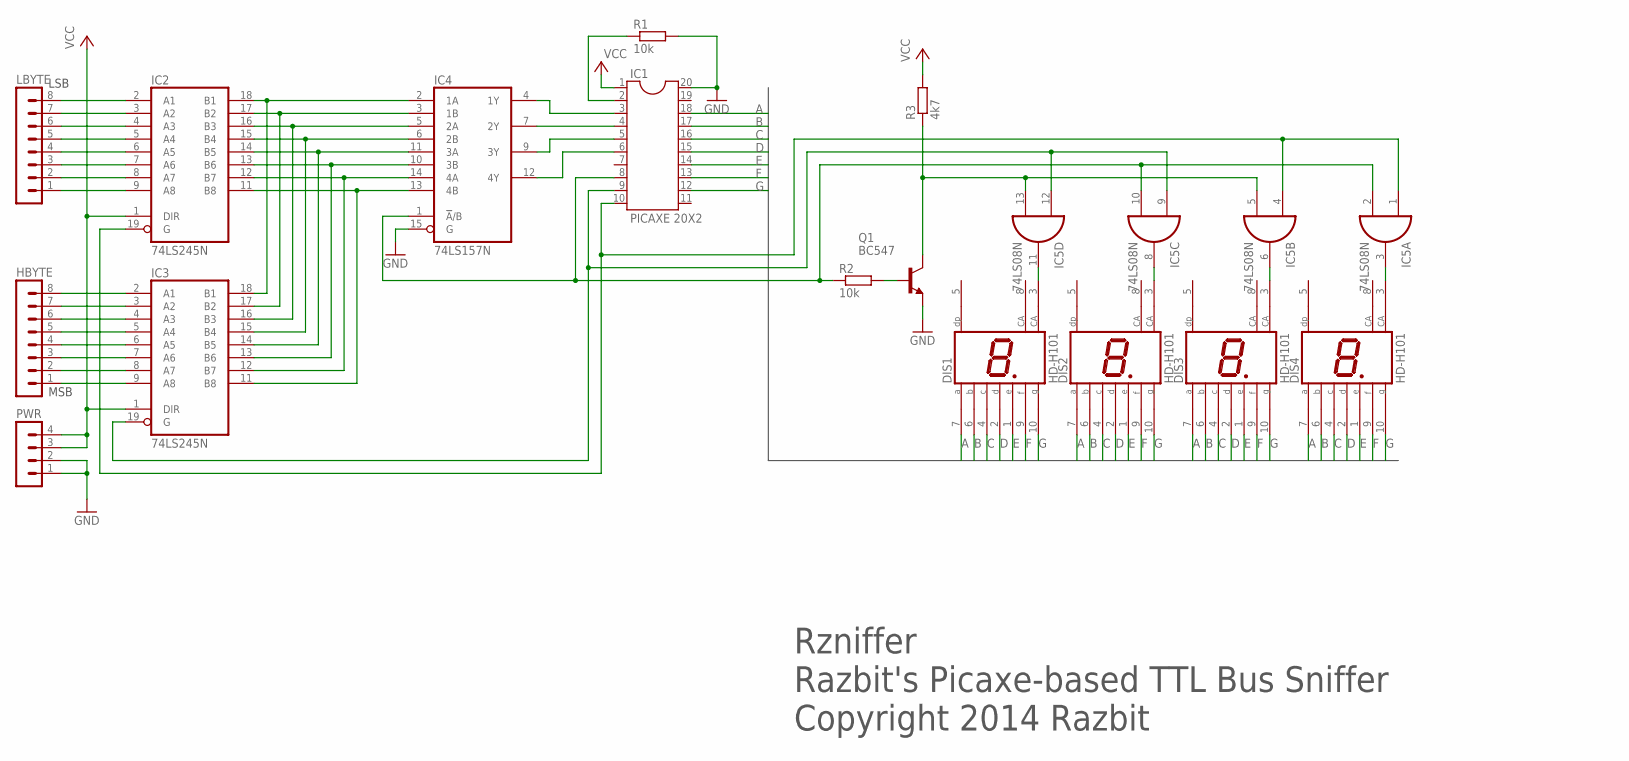
[picture p25: schematic razniffer.sch]

Parts:
DIS1, DIS2, DIS3, DIS4: HD-H101; HDSP-M
HBYTE: MA08-1
IC1: PICAXE 20X2; DIL20
IC2, IC3: 74LS245N; DIL20
IC4: 74LS157N; DIL16
IC5: 74LS08N; DIL14
LBYTE: MA08-1
PWR: MA04-1
Q1: BC547; TO92
R1, R2: 10k; 0204/7
R3: 4k7; 0204/7

Connections:
A: DIS1.7 (A), DIS2.7 (A), DIS3.7 (A), DIS4.7 (A), IC1.18
B: DIS1.6 (B), DIS2.6 (B), DIS3.6 (B), DIS4.6 (B), IC1.17
C: DIS1.4 (C), DIS2.4 (C), DIS3.4 (C), DIS4.4 (C), IC1.16
D: DIS1.2 (D), DIS2.2 (D), DIS3.2 (D), DIS4.2 (D), IC1.15
E: DIS1.1 (E), DIS2.1 (E), DIS3.1 (E), DIS4.1 (E), IC1.14
F: DIS1.9 (F), DIS2.9 (F), DIS3.9 (F), DIS4.9 (F), IC1.13
G: DIS1.10 (G), DIS2.10 (G), DIS3.10 (G), DIS4.10 (G), IC1.12
GND: IC1.20, IC2.10 (GND), IC3.10 (GND), IC4.8 (GND), IC4.15 (G), IC5.7 (GND), PWR.1, PWR.2, Q1.1 (E), R1.2
unnamed: IC2.2 (A1), LBYTE.8
unnamed: IC2.3 (A2), LBYTE.7
unnamed: IC2.4 (A3), LBYTE.6
unnamed: IC2.5 (A4), LBYTE.5
unnamed: IC2.6 (A5), LBYTE.4
unnamed: IC2.7 (A6), LBYTE.3
unnamed: IC2.8 (A7), LBYTE.2
unnamed: IC2.9 (A8), LBYTE.1
unnamed: HBYTE.8, IC3.2 (A1)
unnamed: HBYTE.7, IC3.3 (A2)
unnamed: HBYTE.6, IC3.4 (A3)
unnamed: HBYTE.5, IC3.5 (A4)
unnamed: HBYTE.4, IC3.6 (A5)
unnamed: HBYTE.3, IC3.7 (A6)
unnamed: HBYTE.2, IC3.8 (A7)
unnamed: HBYTE.1, IC3.9 (A8)
unnamed: IC5.5 (I1), IC5.13 (I1), Q1.3 (C), R3.1
unnamed: IC2.18 (B1), IC3.18 (B1), IC4.2 (1A)
unnamed: IC2.17 (B2), IC3.17 (B2), IC4.3 (1B)
unnamed: IC2.16 (B3), IC3.16 (B3), IC4.5 (2A)
unnamed: IC2.15 (B4), IC3.15 (B4), IC4.6 (2B)
unnamed: IC2.14 (B5), IC3.14 (B5), IC4.11 (3A)
unnamed: IC2.13 (B6), IC3.13 (B6), IC4.10 (3B)
unnamed: IC2.12 (B7), IC3.12 (B7), IC4.14 (4A)
unnamed: IC2.11 (B8), IC3.11 (B8), IC4.13 (4B)
unnamed: Q1.2 (B), R2.2
unnamed: IC1.2, R1.1
unnamed: IC1.3, IC4.4 (1Y)
unnamed: IC1.4, IC4.7 (2Y)
unnamed: IC1.5, IC4.9 (3Y)
unnamed: IC1.6, IC4.12 (4Y)
unnamed: IC1.10, IC2.19 (G), IC5.1 (I0), IC5.4 (I0)
unnamed: IC1.9, IC3.19 (G), IC5.9 (I0), IC5.12 (I0)
unnamed: IC1.8, IC4.1 (!A!/B), IC5.2 (I1), IC5.10 (I1), R2.1
unnamed: DIS1.3 (CA), IC5.11 (O)
unnamed: DIS2.3 (CA), IC5.8 (O)
unnamed: DIS3.3 (CA), IC5.6 (O)
unnamed: DIS4.3 (CA), IC5.3 (O)
VCC: IC1.1, IC2.1 (DIR), IC2.20 (VCC), IC3.1 (DIR), IC3.20 (VCC), IC4.16 (VCC), IC5.14 (VCC), PWR.3, PWR.4, R3.2

Notes on the sheet:
Rzniffer Razbit's Picaxe-based TTL Bus Sniffer Copyright 2014 Razbit
LSB
MSB

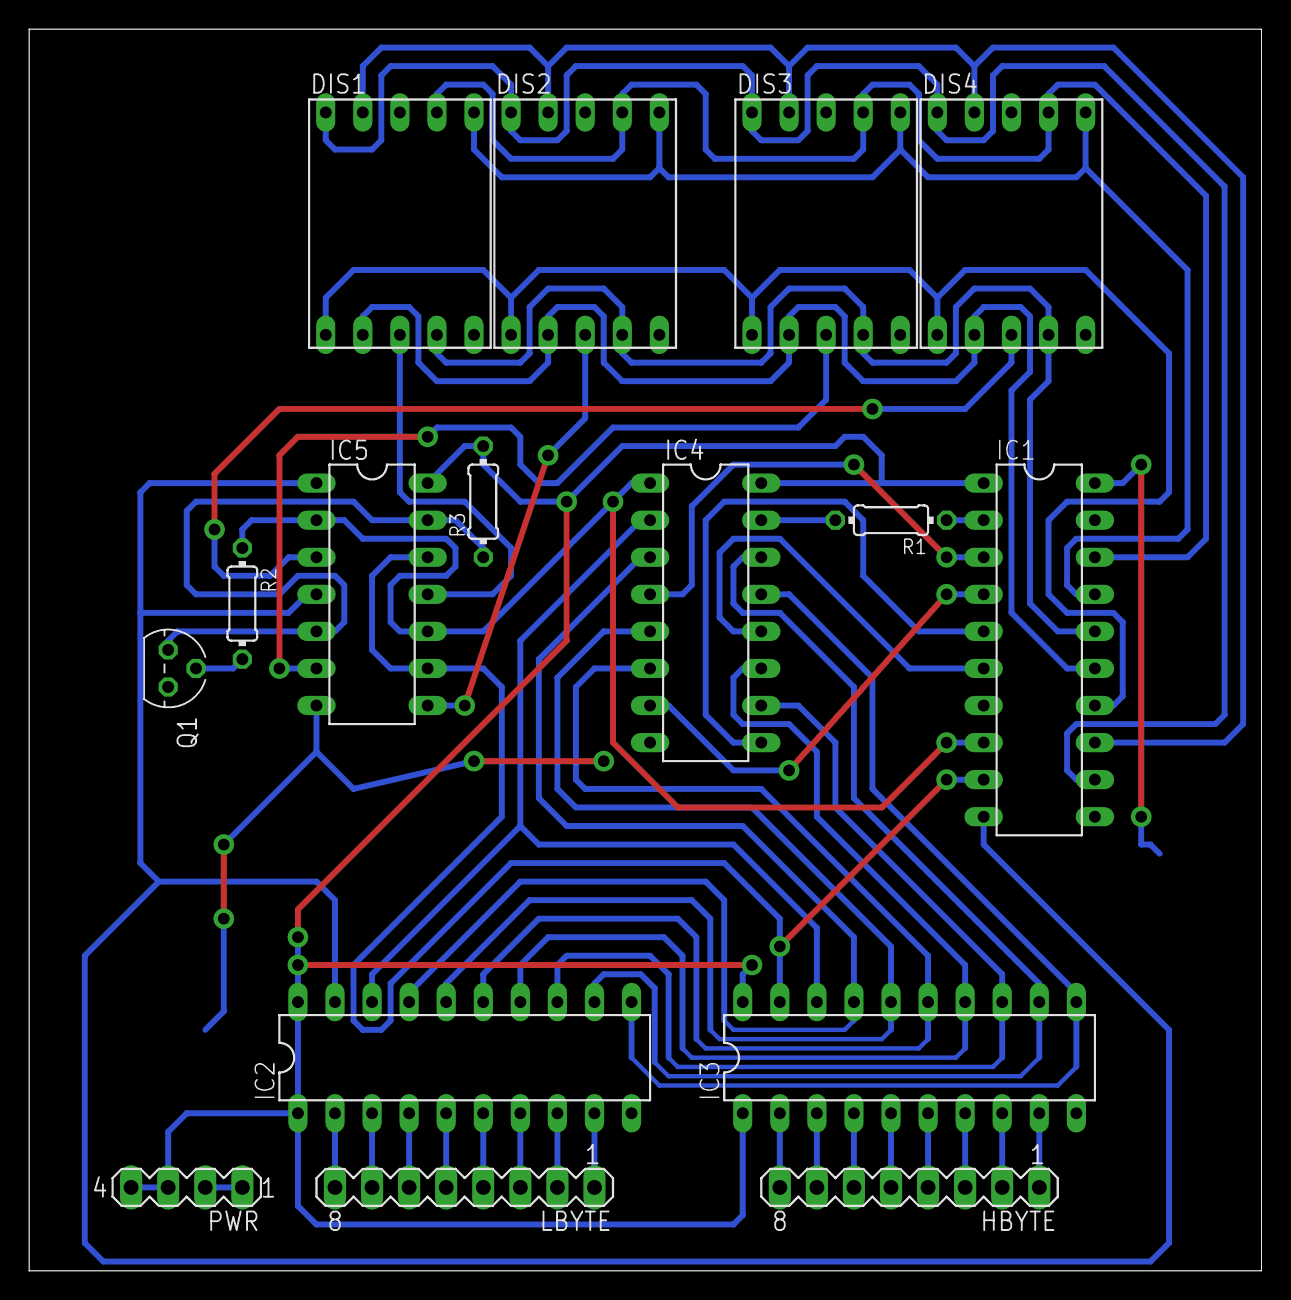
[picture p26: board razniffer.brd from above]

Board: 2 copper layers, 84.4 x 85.1 mm, 16 parts (0 on the bottom side), 47 nets.
